banbatakumi/RCJ2024_OPEN/Software/RobotViewer/robot_image.png

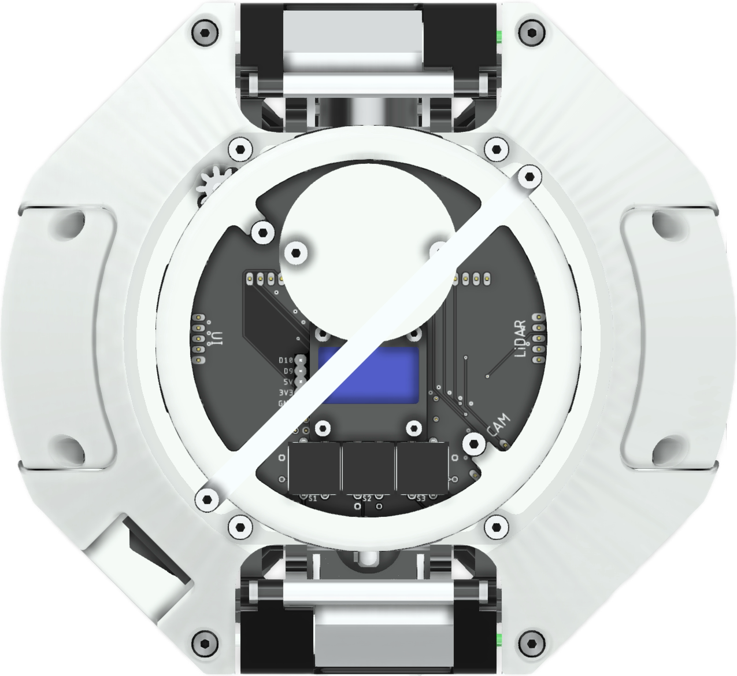
Software/RobotViewer/robot_image.png
