banbatakumi/RCJ2024_OPEN/Hardware/Curcuit/kicker_ver/kicker/kicker.brd

## EAGLE design Hardware/Curcuit/kicker_ver/kicker/kicker.brd (2025-04-20)

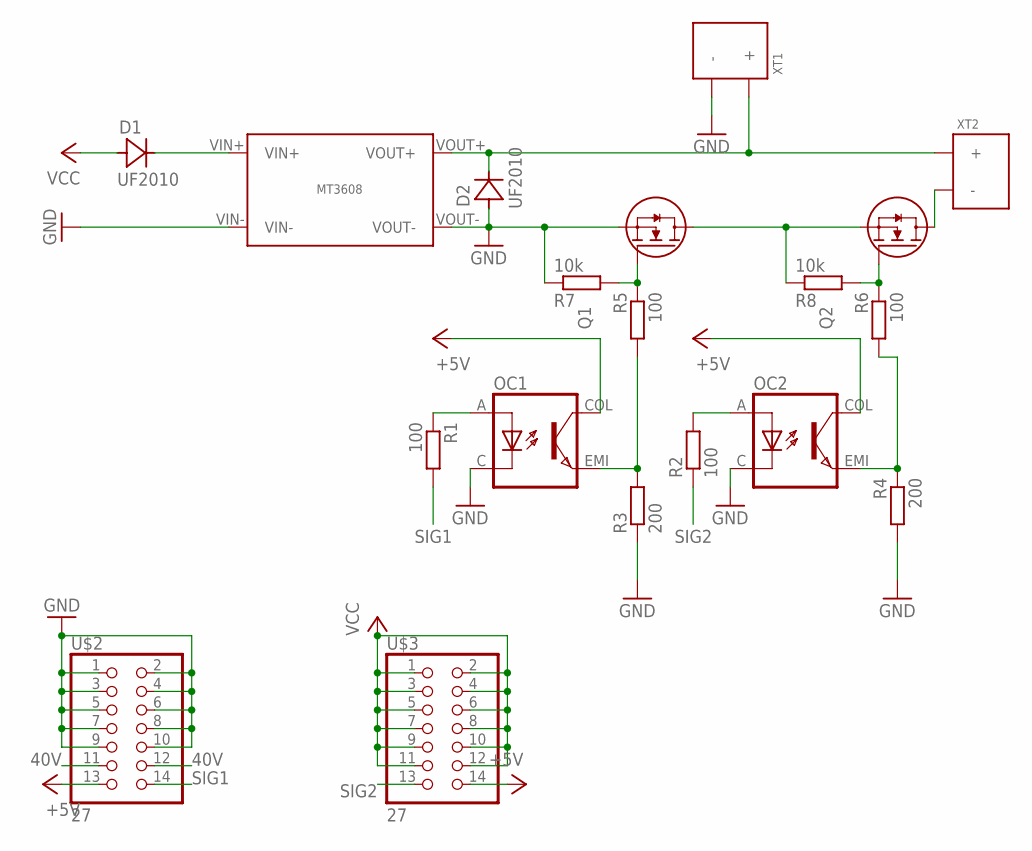
[picture p2: schematic kicker.sch]

Parts:
D1, D2: UF2010
OC1, OC2: TL293(GB); SOIC127P700X230-4N
Q1, Q2: NP52N06SLG; TO230P1040X230-3N
R1, R2, R5, R6: 100; R0603
R3, R4: 200; R0603
R7, R8: 10k; R0603
U$1: MT3608
U$2, U$3: 27; 2*7
XT1, XT2: XT30PW-F

Connections:
40V: D2.C, U$1.VOUT+, U$2.11, U$2.12, XT1.+, XT2.+
+5V: OC1.COL, OC2.COL, U$2.13, U$3.14
GND: D2.A, OC1.C, OC2.C, Q1.S, R3.1, R4.2, R7.1, U$1.VIN-, U$1.VOUT-, U$2.1, U$2.2, U$2.3, U$2.4, U$2.5, U$2.6, U$2.7, U$2.8, U$2.9, U$2.10, XT1.-
unnamed: D1.C, U$1.VIN+
unnamed: Q1.D, Q2.S, R8.1
unnamed: OC1.EMI, R3.2, R5.2
unnamed: Q2.D, XT2.-
unnamed: OC1.A, R1.1
unnamed: OC2.A, R2.2
unnamed: OC2.EMI, R4.1, R6.2
unnamed: Q1.G, R5.1, R7.2
unnamed: Q2.G, R6.1, R8.2
SIG1: R1.2, U$2.14
SIG2: R2.1, U$3.13
VCC: D1.A, U$3.1, U$3.2, U$3.3, U$3.4, U$3.5, U$3.6, U$3.7, U$3.8, U$3.9, U$3.10, U$3.11, U$3.12

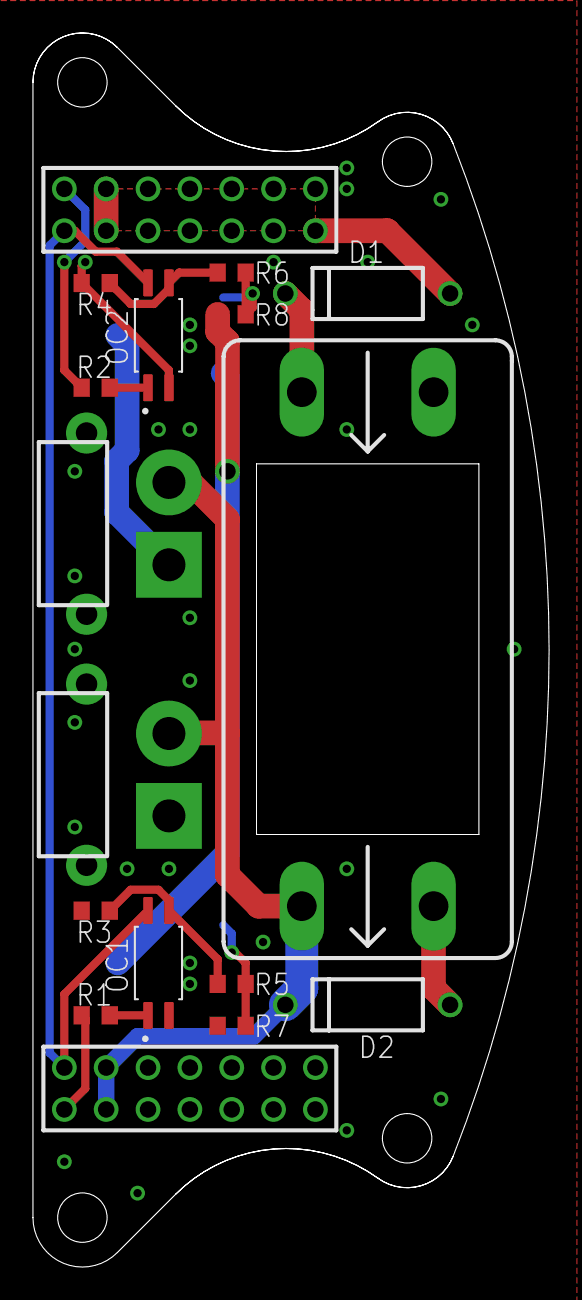
[picture p3: board kicker.brd from above]

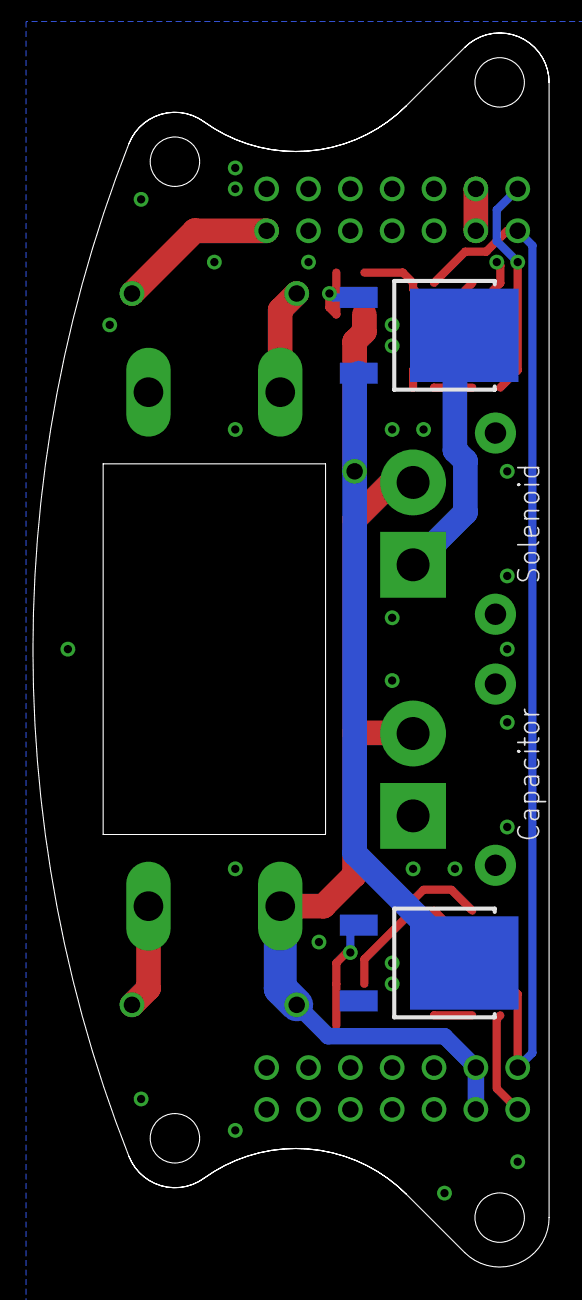
[picture p4: board kicker.brd from below]

Board: 2 copper layers, 31.3 x 74.9 mm, 19 parts (2 on the bottom side), 15 nets.
