banbatakumi/RCJ2024_OPEN/Hardware/Curcuit/Line/Line.brd

## EAGLE design Hardware/Curcuit/Line/Line.brd (2025-04-20)

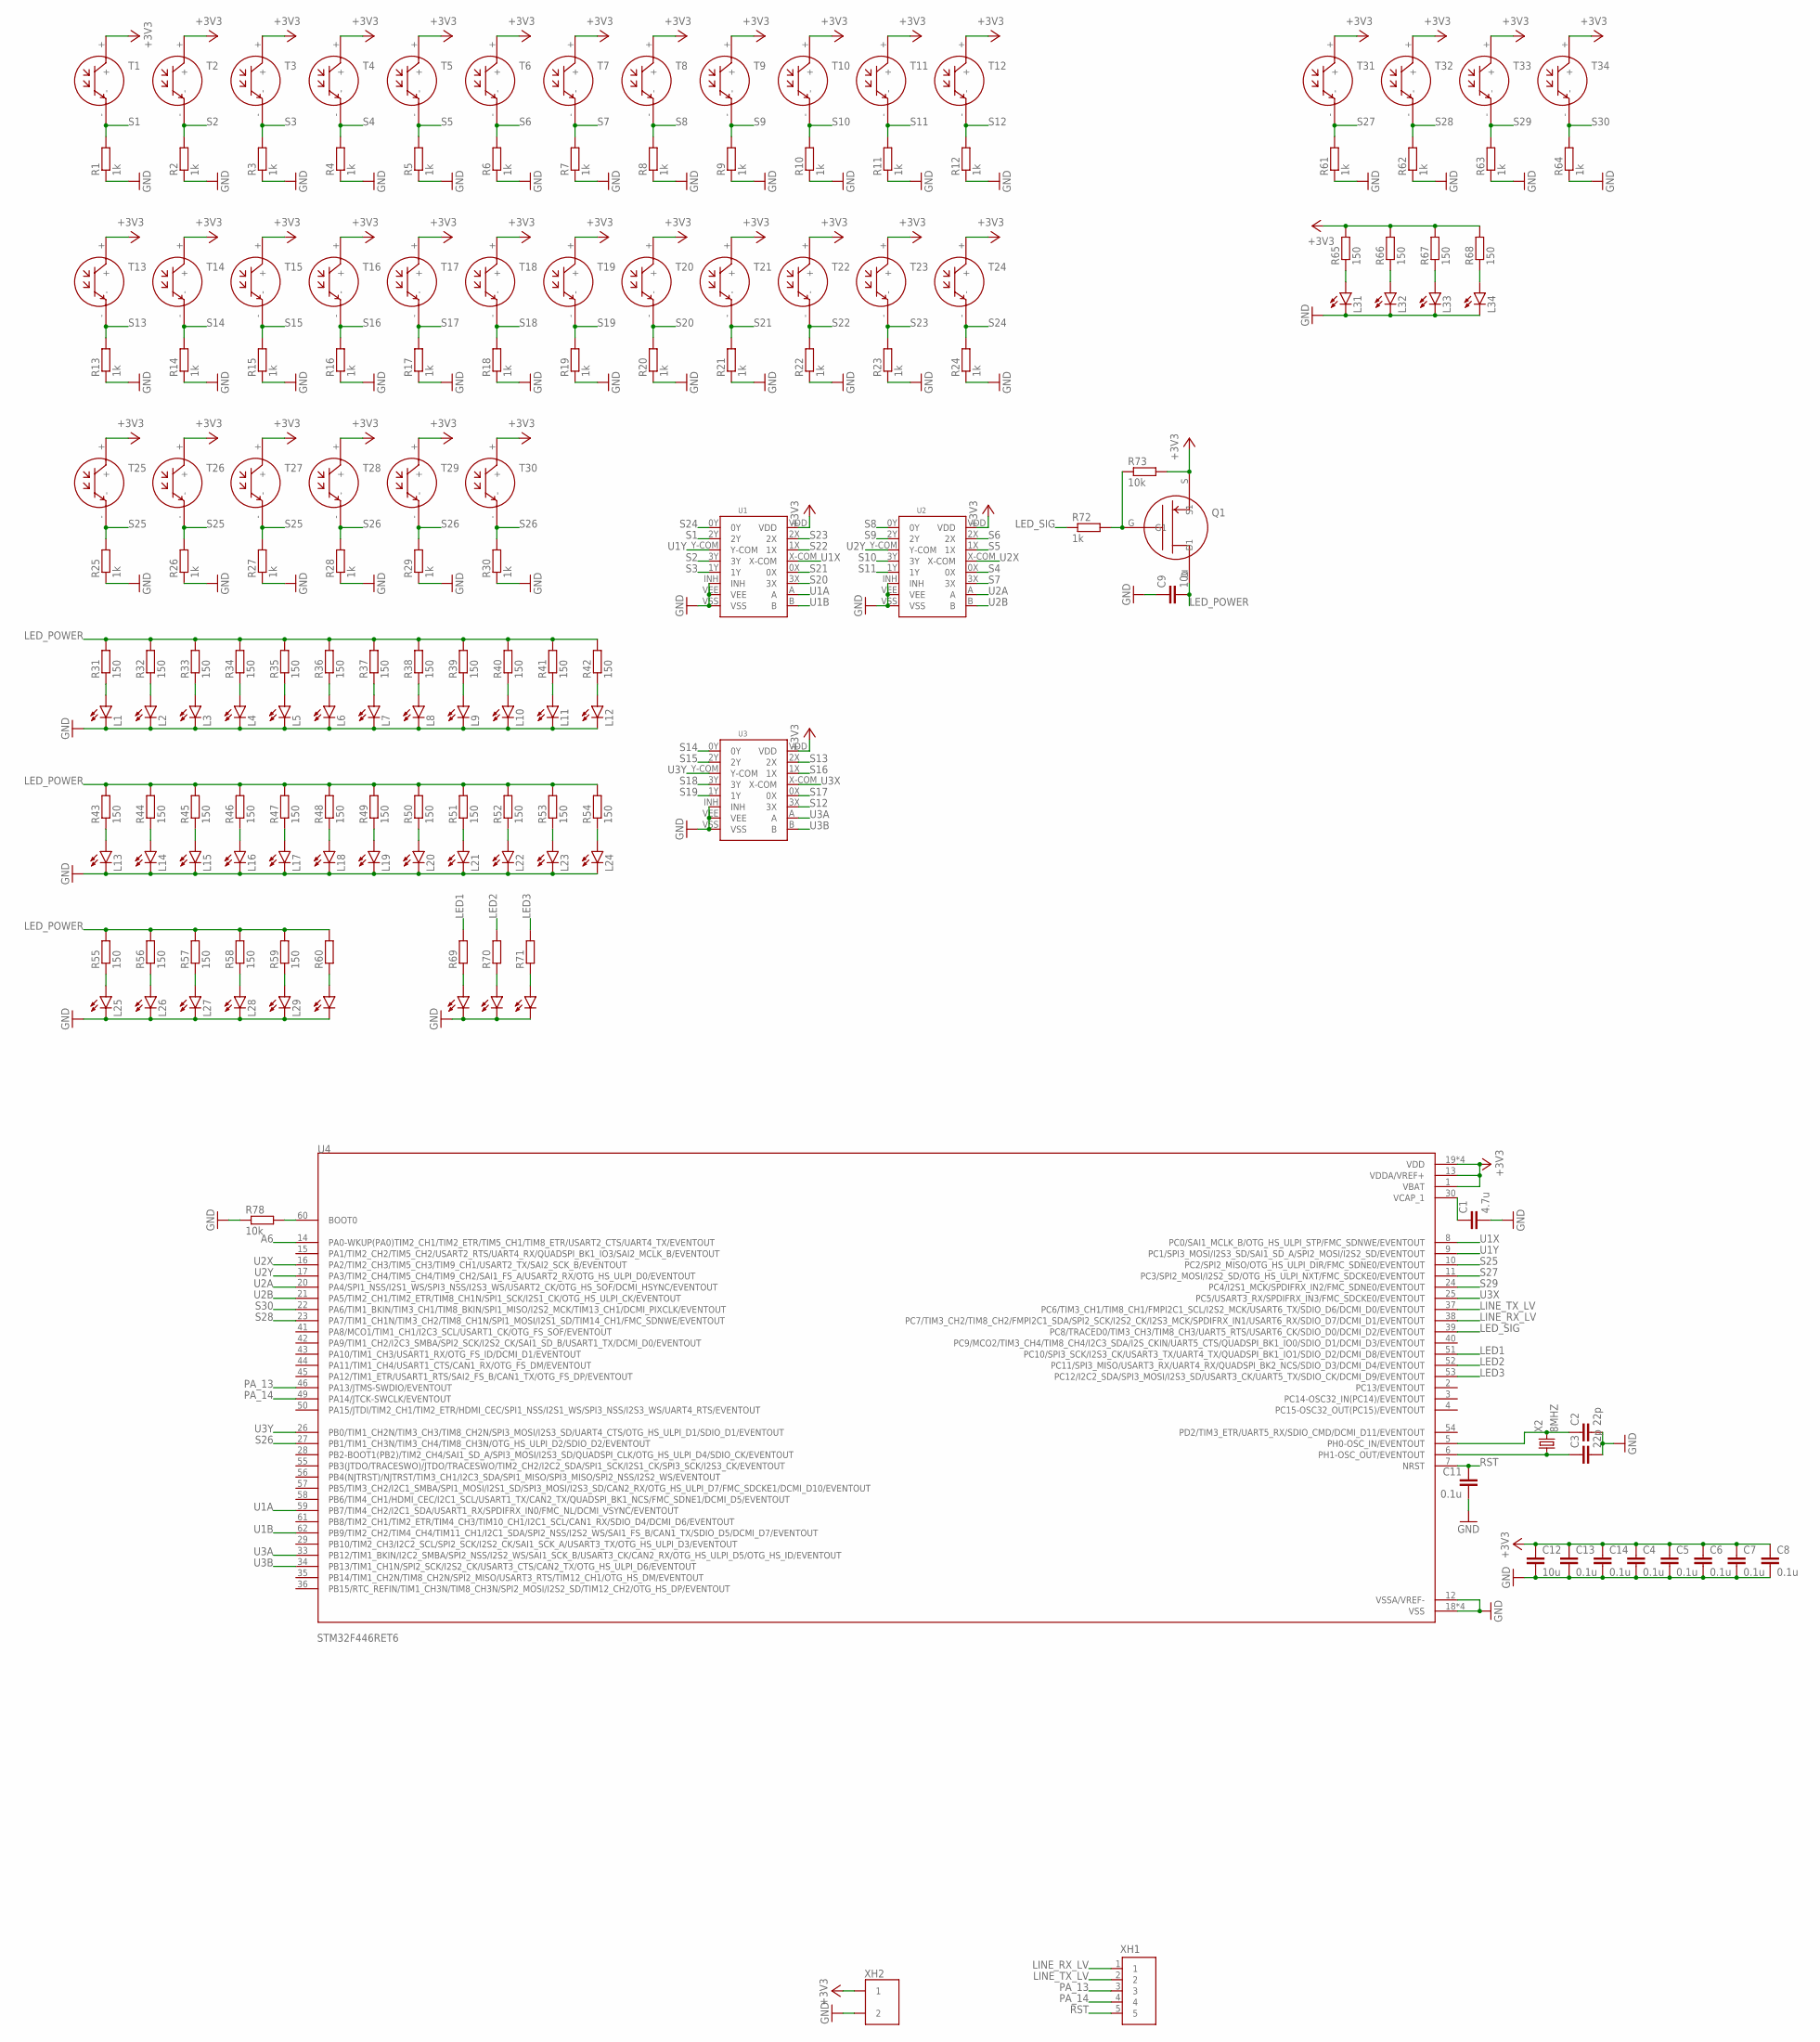
[picture p5: schematic Line.sch]

Parts:
C1: 4.7u; C0603
C2, C3: 22p; C0603
C4, C5, C6, C7, C8, C11, C13, C14: 0.1u; C0603
C9, C12: 10u; C0805
L1, L2, L3, L4, L5, L6, L7, L8, L9, L10, L11, L12, L13, L14, L15, L16, L17, L18, L19, L20, L21, L22, L23, L24, L25, L26, L27, L28, L29, L30, L31, L32, L33, L34, L35, L36, L37: SML-E12P8WT86; LED_SML-LXFM0603SIC-TR
Q1: TJ60S04M3L; DPACK
R1, R2, R3, R4, R5, R6, R7, R8, R9, R10, R11, R12, R13, R14, R15, R16, R17, R18, R19, R20, R21, R22, R23, R24, R25, R26, R27, R28, R29, R30, R61, R62, R63, R64, R72: 1k; R0603
R31, R32, R33, R34, R35, R36, R37, R38, R39, R40, R41, R42, R43, R44, R45, R46, R47, R48, R49, R50, R51, R52, R53, R54, R55, R56, R57, R58, R59, R60, R65, R66, R67, R68, R69, R70, R71: 150; R0603
R73, R78: 10k; R0603
T1, T2, T3, T4, T5, T6, T7, T8, T9, T10, T11, T12, T13, T14, T15, T16, T17, T18, T19, T20, T21, T22, T23, T24, T25, T26, T27, T28, T29, T30, T31, T32, T33, T34: NJL7302L-F3
U1, U2, U3: TC4051BP
U4: STM32F446RET6; QFP50P1200X1200X160-64N
X2: 8MHZ; 16MHZ
XH1: 5B
XH2: 2B

Connections:
+3V3: C4.1, C5.1, C6.1, C7.1, C8.1, C12.1, C13.1, C14.1, Q1.S (S1), R65.2, R66.2, R67.2, R68.2, R73.2, T1.+, T2.+, T3.+, T4.+, T5.+, T6.+, T7.+, T8.+, T9.+, T10.+, T11.+, T12.+, T13.+, T14.+, T15.+, T16.+, T17.+, T18.+, T19.+, T20.+, T21.+, T22.+, T23.+, T24.+, T25.+, T26.+, T27.+, T28.+, T29.+, T30.+, T31.+, T32.+, T33.+, T34.+, U1.VDD, U2.VDD, U3.VDD, U4.1 (VBAT), U4.13 (VDDA/VREF+), U4.19 (VDD), U4.32 (VDD), U4.48 (VDD), U4.64 (VDD), XH2.P$1 (1)
A6: U4.14 (PA0-WKUP(PA0)TIM2_CH1/TIM2_ETR/TIM5_CH1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)
GND: C1.2, C2.2, C3.2, C4.2, C5.2, C6.2, C7.2, C8.2, C9.1, C11.2, C12.2, C13.2, C14.2, L1.C, L2.C, L3.C, L4.C, L5.C, L6.C, L7.C, L8.C, L9.C, L10.C, L11.C, L12.C, L13.C, L14.C, L15.C, L16.C, L17.C, L18.C, L19.C, L20.C, L21.C, L22.C, L23.C, L24.C, L25.C, L26.C, L27.C, L28.C, L29.C, L30.C, L31.C, L32.C, L33.C, L34.C, L35.C, L36.C, L37.C, R1.1, R2.1, R3.1, R4.1, R5.1, R6.1, R7.1, R8.1, R9.1, R10.1, R11.1, R12.1, R13.1, R14.1, R15.1, R16.1, R17.1, R18.1, R19.1, R20.1, R21.1, R22.1, R23.1, R24.1, R25.1, R26.1, R27.1, R28.1, R29.1, R30.1, R61.1, R62.1, R63.1, R64.1, R78.1, U1.INH, U1.VEE, U1.VSS, U2.INH, U2.VEE, U2.VSS, U3.INH, U3.VEE, U3.VSS, U4.12 (VSSA/VREF-), U4.18 (VSS), U4.31 (VSS), U4.47 (VSS), U4.63 (VSS), XH2.P$2 (2)
LED1: R69.2, U4.51 (PC10/SPI3_SCK/I2S3_CK/USART3_TX/UART4_T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)
LED2: R70.2, U4.52 (PC11/SPI3_MISO/USART3_RX/UART4_RX/QUADS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)
LED3: R71.2, U4.53 (PC12/I2C2_SDA/SPI3_MOSI/I2S3_SD/USART3_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)
LED_POWER: C9.2, Q1.D (D1), R31.2, R32.2, R33.2, R34.2, R35.2, R36.2, R37.2, R38.2, R39.2, R40.2, R41.2, R42.2, R43.2, R44.2, R45.2, R46.2, R47.2, R48.2, R49.2, R50.2, R51.2, R52.2, R53.2, R54.2, R55.2, R56.2, R57.2, R58.2, R59.2, R60.2
LED_SIG: R72.1, U4.39 (PC8/TRACED0/TIM3_CH3/TIM8_CH3/UART5_RTS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)
LINE_RX_LV: U4.38 (PC7/TIM3_CH2/TIM8_CH2/FMPI2C1_SDA/SPI2_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), XH1.1
LINE_TX_LV: U4.37 (PC6/TIM3_CH1/TIM8_CH1/FMPI2C1_SCL/I2S2_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), XH1.2
unnamed: L1.A, R31.1
unnamed: L2.A, R32.1
unnamed: L3.A, R33.1
unnamed: L4.A, R34.1
unnamed: L5.A, R35.1
unnamed: L6.A, R36.1
unnamed: L7.A, R37.1
unnamed: L8.A, R38.1
unnamed: L9.A, R39.1
unnamed: L10.A, R40.1
unnamed: L11.A, R41.1
unnamed: L12.A, R42.1
unnamed: L13.A, R43.1
unnamed: L14.A, R44.1
unnamed: L15.A, R45.1
unnamed: L16.A, R46.1
unnamed: L17.A, R47.1
unnamed: L18.A, R48.1
unnamed: L19.A, R49.1
unnamed: L20.A, R50.1
unnamed: L21.A, R51.1
unnamed: L22.A, R52.1
unnamed: L23.A, R53.1
unnamed: L24.A, R54.1
unnamed: L25.A, R55.1
unnamed: L26.A, R56.1
unnamed: L27.A, R57.1
unnamed: L28.A, R58.1
unnamed: L29.A, R59.1
unnamed: L30.A, R60.1
unnamed: L31.A, R65.1
unnamed: L32.A, R66.1
unnamed: L33.A, R67.1
unnamed: L34.A, R68.1
unnamed: L35.A, R69.1
unnamed: L36.A, R70.1
unnamed: L37.A, R71.1
unnamed: Q1.G (G1), R72.2, R73.1
unnamed: C1.1, U4.30 (VCAP_1)
unnamed: R78.2, U4.60 (BOOT0)
unnamed: C2.1, U4.5 (PH0-OSC_IN/EVENTOUT), X2.P$2 (2)
unnamed: C3.1, U4.6 (PH1-OSC_OUT/EVENTOUT), X2.P$1 (1)
PA_13: U4.46 (PA13/JTMS-SWDIO/EVENTOUT), XH1.3
PA_14: U4.49 (PA14/JTCK-SWCLK/EVENTOUT), XH1.4
RST: C11.1, U4.7 (NRST), XH1.5
S1: R1.2, T1.-, U1.2Y
S2: R2.2, T2.-, U1.3Y
S3: R3.2, T3.-, U1.1Y
S4: R4.2, T4.-, U2.0X
S5: R5.2, T5.-, U2.1X
S6: R6.2, T6.-, U2.2X
S7: R7.2, T7.-, U2.3X
S8: R8.2, T8.-, U2.0Y
S9: R9.2, T9.-, U2.2Y
S10: R10.2, T10.-, U2.3Y
S11: R11.2, T11.-, U2.1Y
S12: R12.2, T12.-, U3.3X
S13: R13.2, T13.-, U3.2X
S14: R14.2, T14.-, U3.0Y
S15: R15.2, T15.-, U3.2Y
S16: R16.2, T16.-, U3.1X
S17: R17.2, T17.-, U3.0X
S18: R18.2, T18.-, U3.3Y
S19: R19.2, T19.-, U3.1Y
S20: R20.2, T20.-, U1.3X
S21: R21.2, T21.-, U1.0X
S22: R22.2, T22.-, U1.1X
S23: R23.2, T23.-, U1.2X
S24: R24.2, T24.-, U1.0Y
S25: R25.2, R26.2, R27.2, T25.-, T26.-, T27.-, U4.10 (PC2/SPI2_MISO/OTG_HS_ULPI_DIR/FMC_SDNE0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)
S26: R28.2, R29.2, R30.2, T28.-, T29.-, T30.-, U4.27 (PB1/TIM1_CH3N/TIM3_CH4/TIM8_CH3N/OTG_HS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)
S27: R61.2, T31.-, U4.11 (PC3/SPI2_MOSI/I2S2_SD/OTG_HS_ULPI_NXT/F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)
S28: R62.2, T32.-, U4.23 (PA7/TIM1_CH1N/TIM3_CH2/TIM8_CH1N/SPI1_M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)
S29: R63.2, T33.-, U4.24 (PC4/I2S1_MCK/SPDIFRX_IN2/FMC_SDNE0/EVEN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)
S30: R64.2, T34.-, U4.22 (PA6/TIM1_BKIN/TIM3_CH1/TIM8_BKIN/SPI1_M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)
U1A: U1.A, U4.59 (PB7/TIM4_CH2/I2C1_SDA/USART1_RX/SPDIFRX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)
U1B: U1.B, U4.62 (PB9/TIM2_CH2/TIM4_CH4/TIM11_CH1/I2C1_SD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)
U1X: U1.X-COM, U4.8 (PC0/SAI1_MCLK_B/OTG_HS_ULPI_STP/FMC_SDN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)
U1Y: U1.Y-COM, U4.9 (PC1/SPI3_MOSI/I2S3_SD/SAI1_SD_A/SPI2_MO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)
U2A: U2.A, U4.20 (PA4/SPI1_NSS/I2S1_WS/SPI3_NSS/I2S3_WS/U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)
U2B: U2.B, U4.21 (PA5/TIM2_CH1/TIM2_ETR/TIM8_CH1N/SPI1_SC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)
U2X: U2.X-COM, U4.16 (PA2/TIM2_CH3/TIM5_CH3/TIM9_CH1/USART2_T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)
U2Y: U2.Y-COM, U4.17 (PA3/TIM2_CH4/TIM5_CH4/TIM9_CH2/SAI1_FS_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)
U3A: U3.A, U4.33 (PB12/TIM1_BKIN/I2C2_SMBA/SPI2_NSS/I2S2_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)
U3B: U3.B, U4.34 (PB13/TIM1_CH1N/SPI2_SCK/I2S2_CK/USART3_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)
U3X: U3.X-COM, U4.25 (PC5/USART3_RX/SPDIFRX_IN3/FMC_SDCKE0/EV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)
U3Y: U3.Y-COM, U4.26 (PB0/TIM1_CH2N/TIM3_CH3/TIM8_CH2N/SPI3_M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)

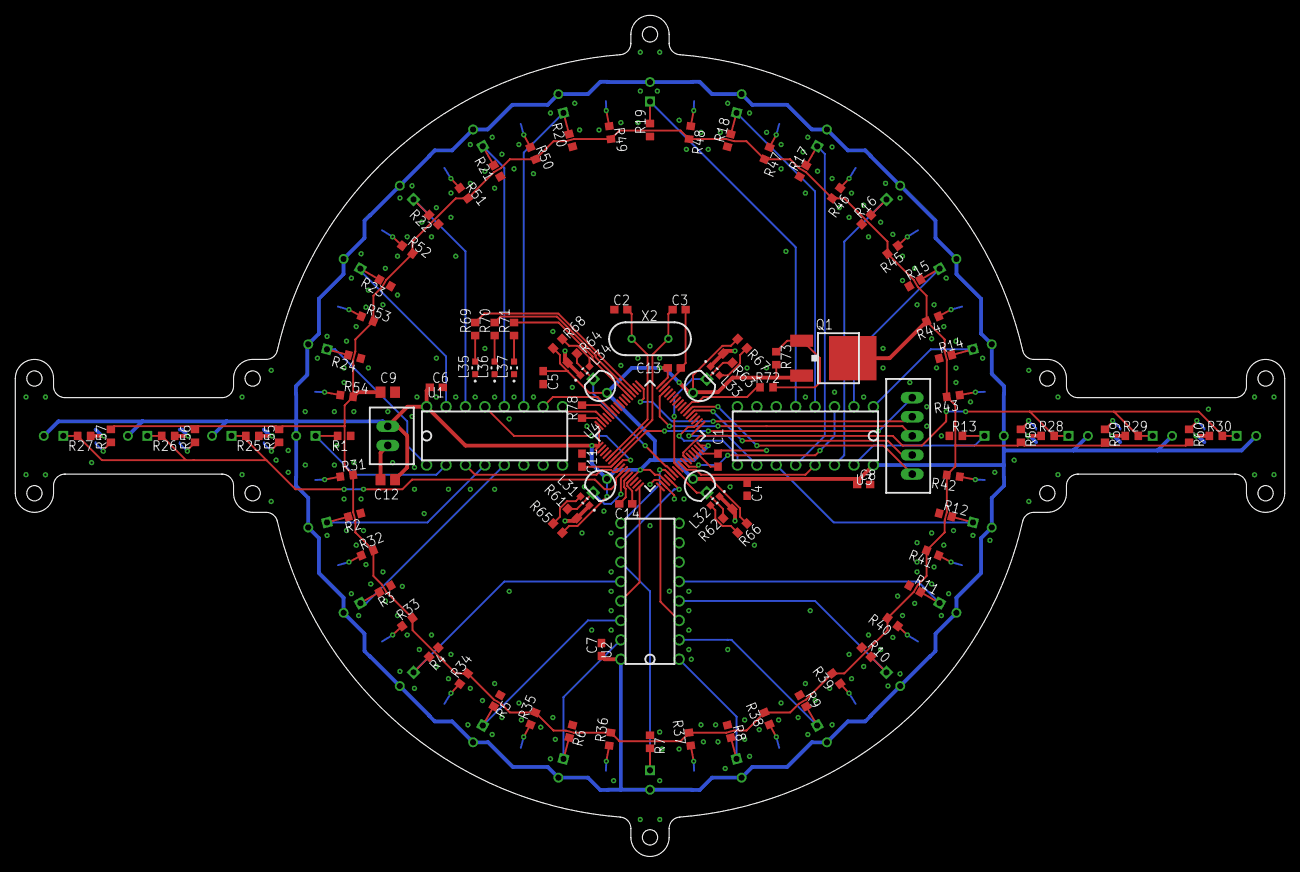
[picture p6: board Line.brd from above]

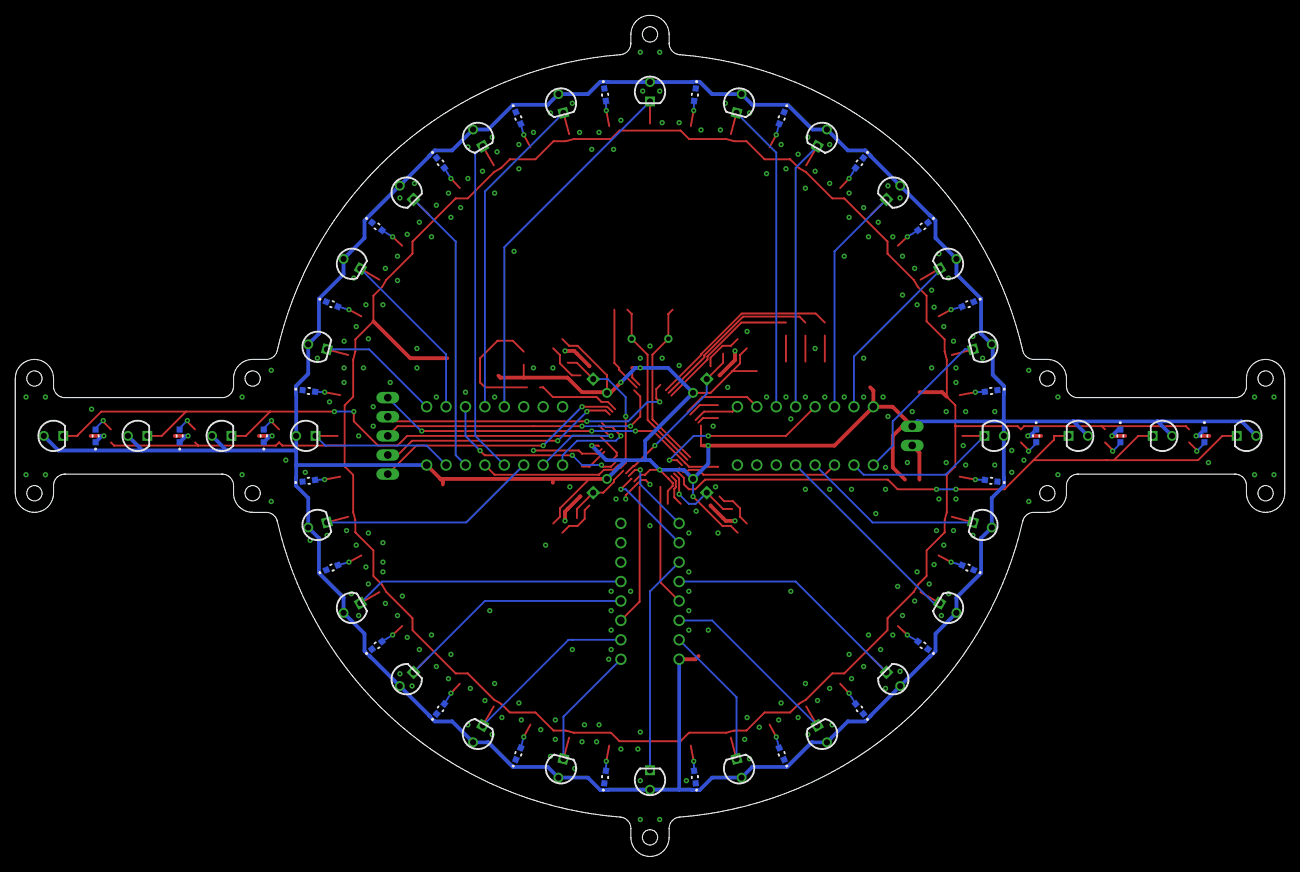
[picture p7: board Line.brd from below]

Board: 2 copper layers, 166.0 x 110.0 mm, 166 parts (60 on the bottom side), 96 nets.
