banbatakumi/RCJ2024_OPEN/Hardware/Curcuit/main_bottom/main_bottom.brd

## EAGLE design Hardware/Curcuit/main_bottom/main_bottom.brd (2025-04-20)

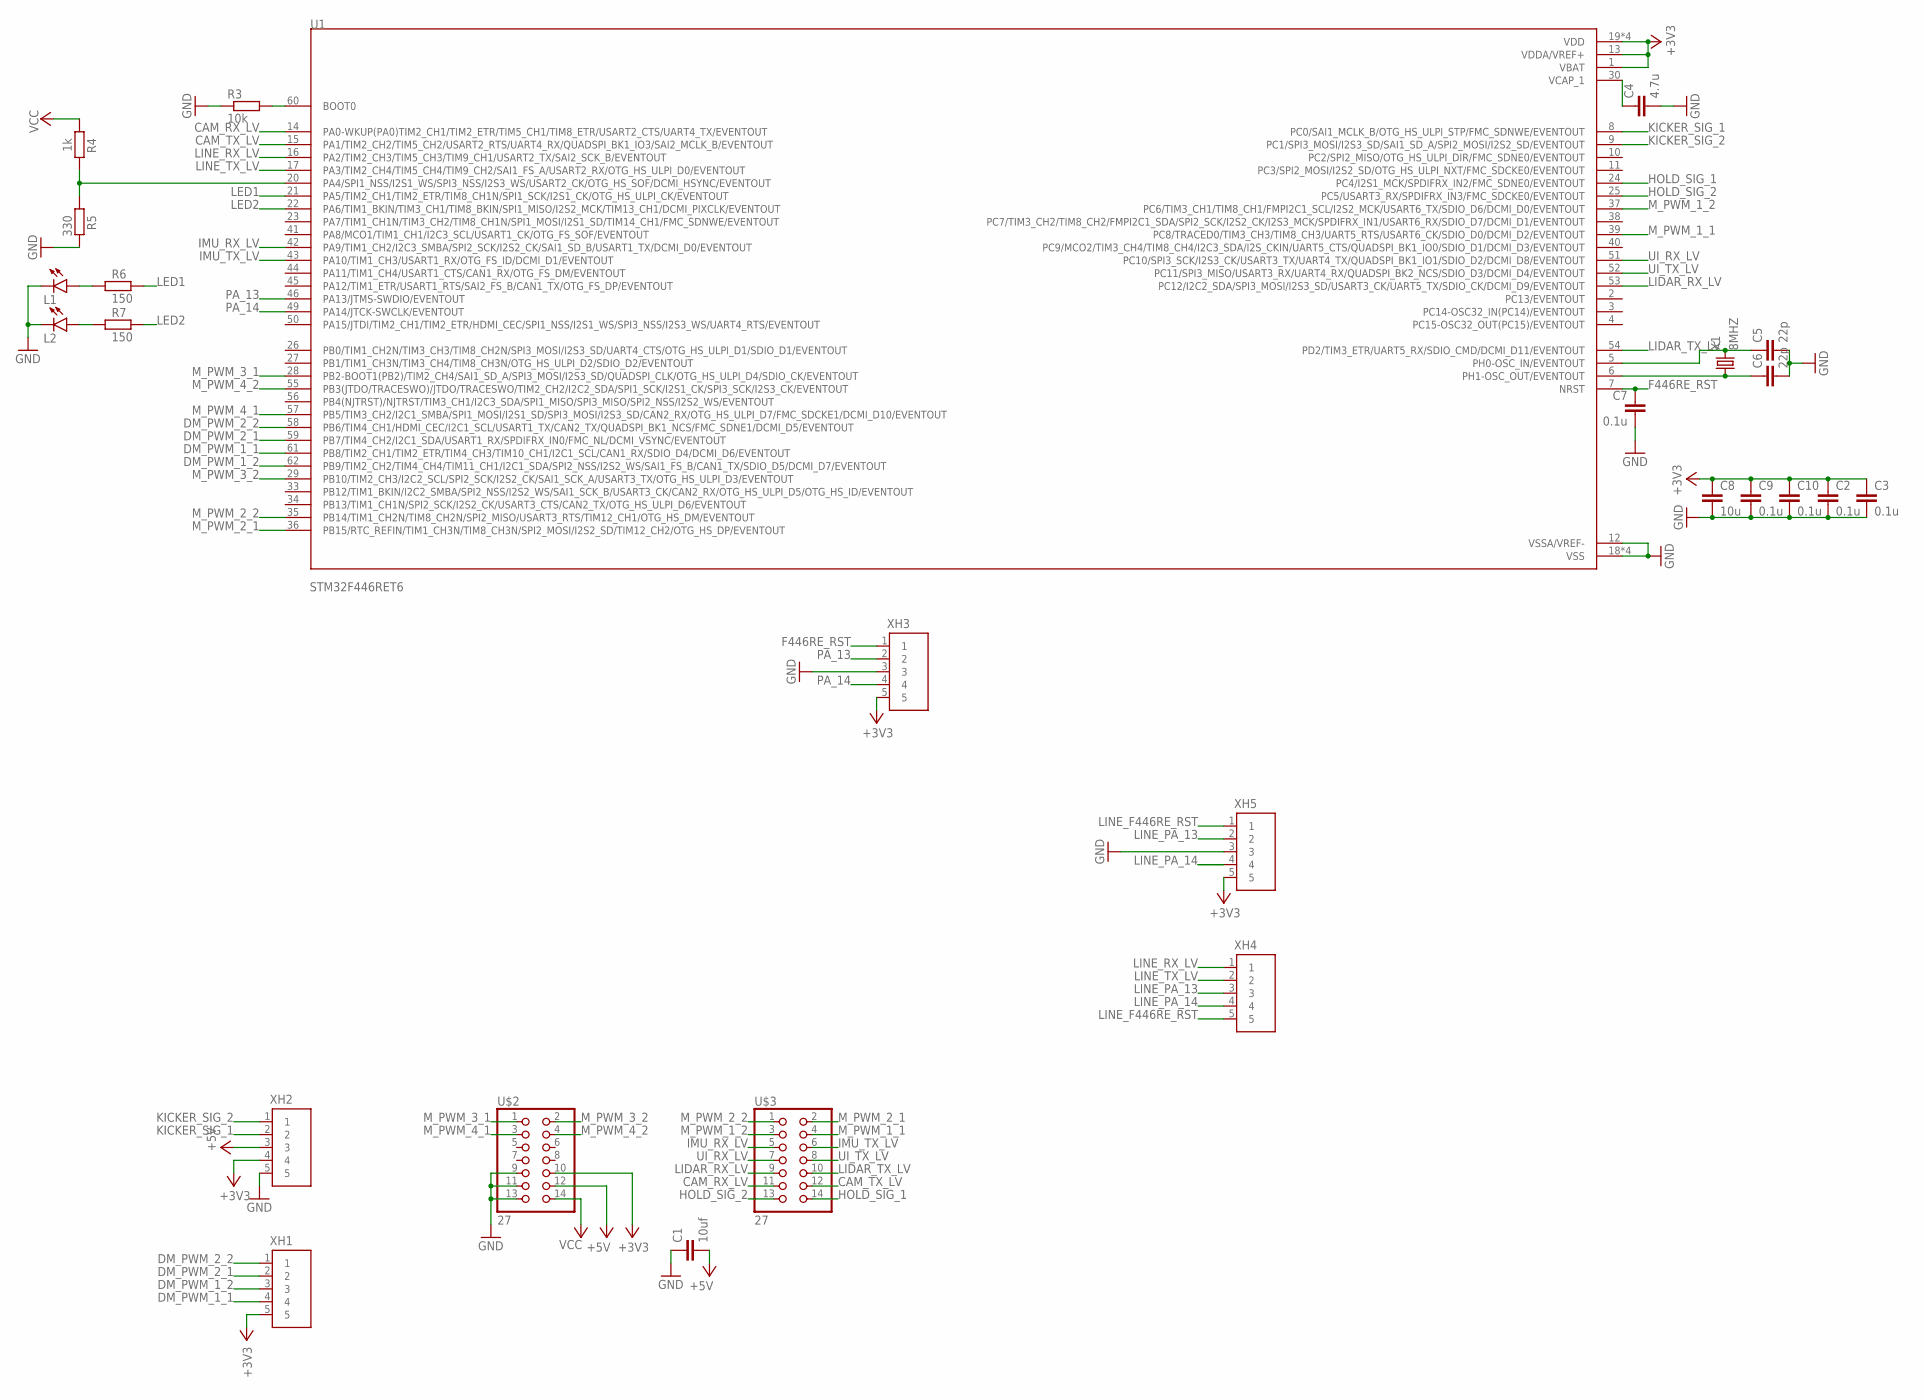
[picture p8: schematic main_bottom.sch]

Parts:
C1: 10uf; C0805
C2, C3, C7, C9, C10: 0.1u; C0603
C4: 4.7u; C0603
C5, C6: 22p; C0603
C8: 10u; C0805
L1, L2: SML-E12P8WT86; LED_SML-LXFM0603SIC-TR
R3: 10k; R0603
R4: 1k; R0603
R5: 330; R0603
R6, R7: 150; R0603
U1: STM32F446RET6; QFP50P1200X1200X160-64N
U$2, U$3: 27; 2*7
X1: 8MHZ; 16MHZ
XH1, XH2, XH3, XH4, XH5: S5B

Connections:
+3V3: C2.1, C3.1, C8.1, C9.1, C10.1, U1.1 (VBAT), U1.13 (VDDA/VREF+), U1.19 (VDD), U1.32 (VDD), U1.48 (VDD), U1.64 (VDD), U$2.10, XH1.5, XH2.4, XH3.5, XH5.5
+5V: C1.2, U$2.12, XH2.3
CAM_RX_LV: U1.14 (PA0-WKUP(PA0)TIM2_CH1/TIM2_ETR/TIM5_CH1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), U$3.11
CAM_TX_LV: U1.15 (PA1/TIM2_CH2/TIM5_CH2/USART2_RTS/UART4_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), U$3.12
DM_PWM_1_1: U1.61 (PB8/TIM2_CH1/TIM2_ETR/TIM4_CH3/TIM10_CH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), XH1.4
DM_PWM_1_2: U1.62 (PB9/TIM2_CH2/TIM4_CH4/TIM11_CH1/I2C1_SD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), XH1.3
DM_PWM_2_1: U1.59 (PB7/TIM4_CH2/I2C1_SDA/USART1_RX/SPDIFRX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), XH1.2
DM_PWM_2_2: U1.58 (PB6/TIM4_CH1/HDMI_CEC/I2C1_SCL/USART1_T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), XH1.1
F446RE_RST: C7.1, U1.7 (NRST), XH3.1
GND: C1.1, C2.2, C3.2, C4.2, C5.2, C6.2, C7.2, C8.2, C9.2, C10.2, L1.C, L2.C, R3.1, R5.2, U1.12 (VSSA/VREF-), U1.18 (VSS), U1.31 (VSS), U1.47 (VSS), U1.63 (VSS), U$2.9, U$2.11, U$2.13, XH2.5, XH3.3, XH5.3
HOLD_SIG_1: U1.24 (PC4/I2S1_MCK/SPDIFRX_IN2/FMC_SDNE0/EVEN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), U$3.14
HOLD_SIG_2: U1.25 (PC5/USART3_RX/SPDIFRX_IN3/FMC_SDCKE0/EV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), U$3.13
IMU_RX_LV: U1.42 (PA9/TIM1_CH2/I2C3_SMBA/SPI2_SCK/I2S2_CK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), U$3.5
IMU_TX_LV: U1.43 (PA10/TIM1_CH3/USART1_RX/OTG_FS_ID/DCMI_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), U$3.6
KICKER_SIG_1: U1.8 (PC0/SAI1_MCLK_B/OTG_HS_ULPI_STP/FMC_SDN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), XH2.2
KICKER_SIG_2: U1.9 (PC1/SPI3_MOSI/I2S3_SD/SAI1_SD_A/SPI2_MO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), XH2.1
LED1: R6.2, U1.21 (PA5/TIM2_CH1/TIM2_ETR/TIM8_CH1N/SPI1_SC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)
LED2: R7.2, U1.22 (PA6/TIM1_BKIN/TIM3_CH1/TIM8_BKIN/SPI1_M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)
LIDAR_RX_LV: U1.53 (PC12/I2C2_SDA/SPI3_MOSI/I2S3_SD/USART3_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), U$3.9
LIDAR_TX_LV: U1.54 (PD2/TIM3_ETR/UART5_RX/SDIO_CMD/DCMI_D11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), U$3.10
LINE_F446RE_RST: XH4.5, XH5.1
LINE_PA_13: XH4.3, XH5.2
LINE_PA_14: XH4.4, XH5.4
LINE_RX_LV: U1.16 (PA2/TIM2_CH3/TIM5_CH3/TIM9_CH1/USART2_T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), XH4.1
LINE_TX_LV: U1.17 (PA3/TIM2_CH4/TIM5_CH4/TIM9_CH2/SAI1_FS_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), XH4.2
M_PWM_1_1: U1.39 (PC8/TRACED0/TIM3_CH3/TIM8_CH3/UART5_RTS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), U$3.4
M_PWM_1_2: U1.37 (PC6/TIM3_CH1/TIM8_CH1/FMPI2C1_SCL/I2S2_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), U$3.3
M_PWM_2_1: U1.36 (PB15/RTC_REFIN/TIM1_CH3N/TIM8_CH3N/SPI2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), U$3.2
M_PWM_2_2: U1.35 (PB14/TIM1_CH2N/TIM8_CH2N/SPI2_MISO/USAR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), U$3.1
M_PWM_3_1: U1.28 (PB2-BOOT1(PB2)/TIM2_CH4/SAI1_SD_A/SPI3_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), U$2.1
M_PWM_3_2: U1.29 (PB10/TIM2_CH3/I2C2_SCL/SPI2_SCK/I2S2_CK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), U$2.2
M_PWM_4_1: U1.57 (PB5/TIM3_CH2/I2C1_SMBA/SPI1_MOSI/I2S1_S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), U$2.3
M_PWM_4_2: U1.55 (PB3(JTDO/TRACESWO)/JTDO/TRACESWO/TIM2_C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), U$2.4
unnamed: C4.1, U1.30 (VCAP_1)
unnamed: R3.2, U1.60 (BOOT0)
unnamed: C5.1, U1.5 (PH0-OSC_IN/EVENTOUT), X1.P$2 (2)
unnamed: C6.1, U1.6 (PH1-OSC_OUT/EVENTOUT), X1.P$1 (1)
unnamed: L2.A, R7.1
unnamed: L1.A, R6.1
PA_13: U1.46 (PA13/JTMS-SWDIO/EVENTOUT), XH3.2
PA_14: U1.49 (PA14/JTCK-SWCLK/EVENTOUT), XH3.4
UI_RX_LV: U1.51 (PC10/SPI3_SCK/I2S3_CK/USART3_TX/UART4_T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), U$3.7
UI_TX_LV: U1.52 (PC11/SPI3_MISO/USART3_RX/UART4_RX/QUADS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), U$3.8
VCC: R4.1, U$2.14
VCC_SIG: R4.2, R5.1, U1.20 (PA4/SPI1_NSS/I2S1_WS/SPI3_NSS/I2S3_WS/U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)

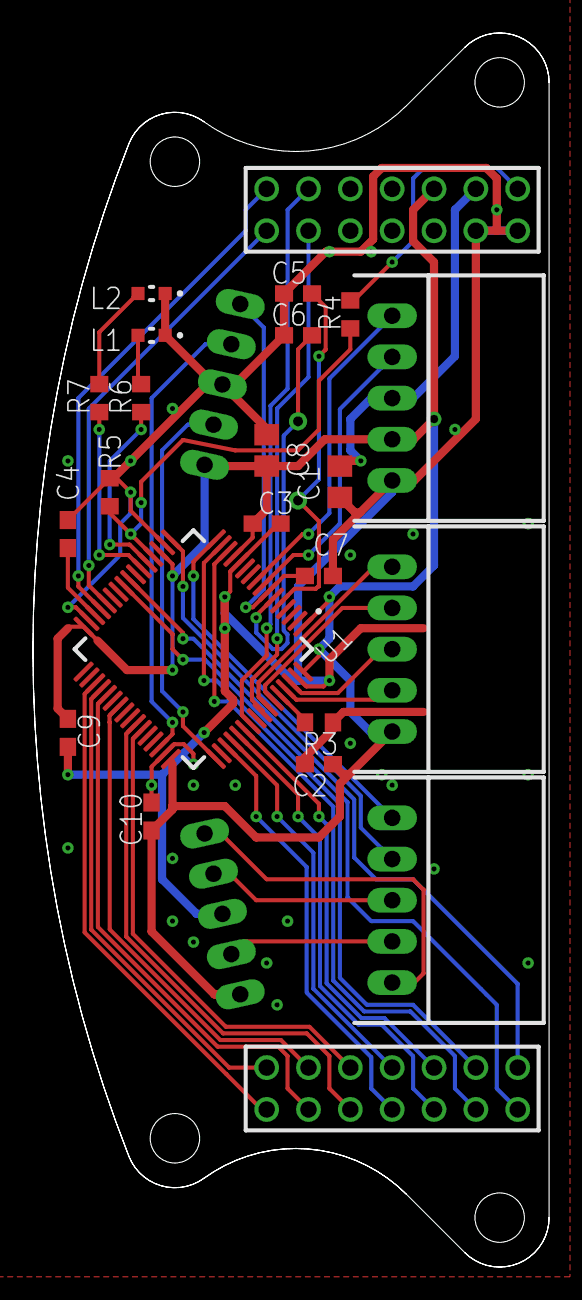
[picture p9: board main_bottom.brd from above]

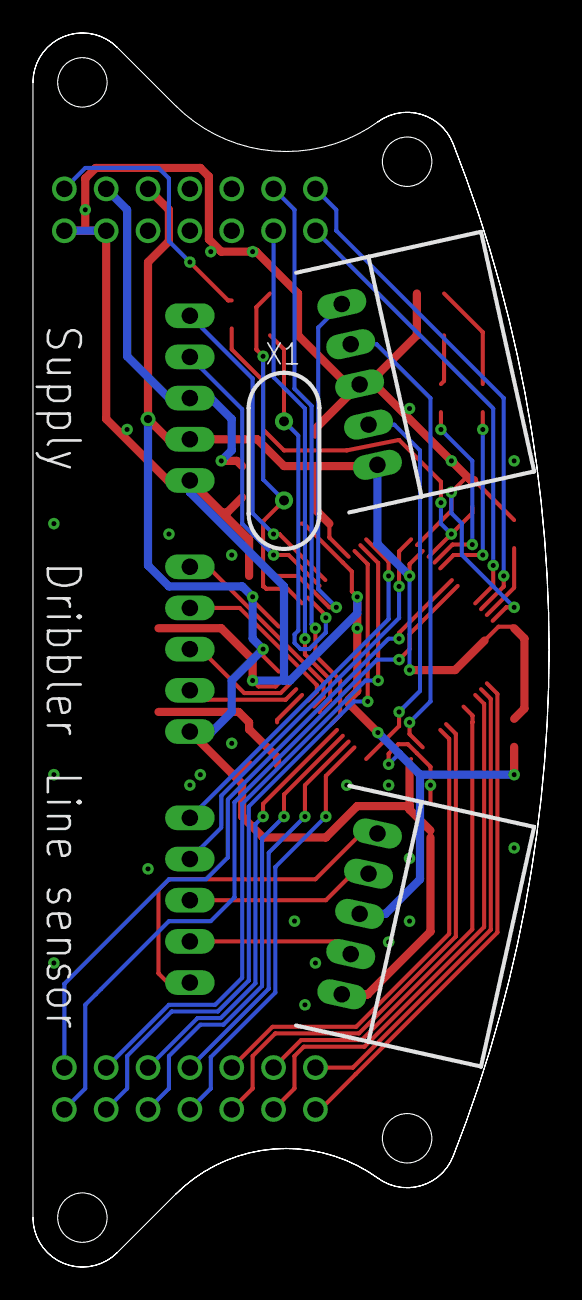
[picture p10: board main_bottom.brd from below]

Board: 2 copper layers, 31.3 x 74.9 mm, 26 parts (3 on the bottom side), 45 nets.
