banbatakumi/RCJ2024_OPEN/Hardware/Curcuit/main_top/main_top.brd

## EAGLE design Hardware/Curcuit/main_top/main_top.brd (continued)

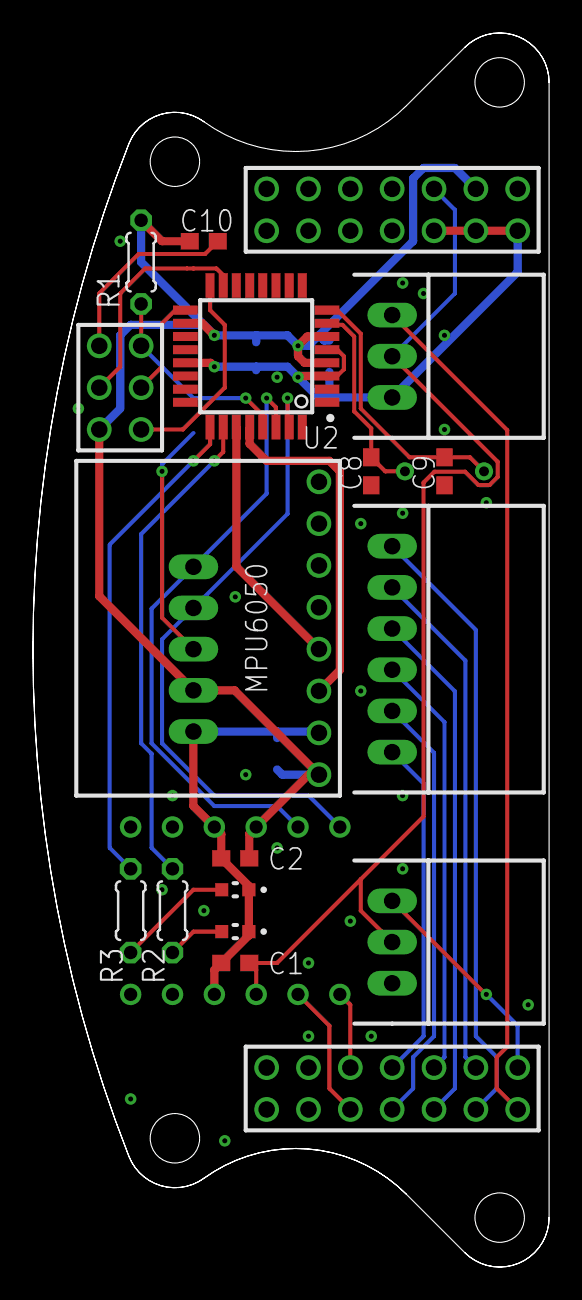
[picture p12: board main_top.brd from above]

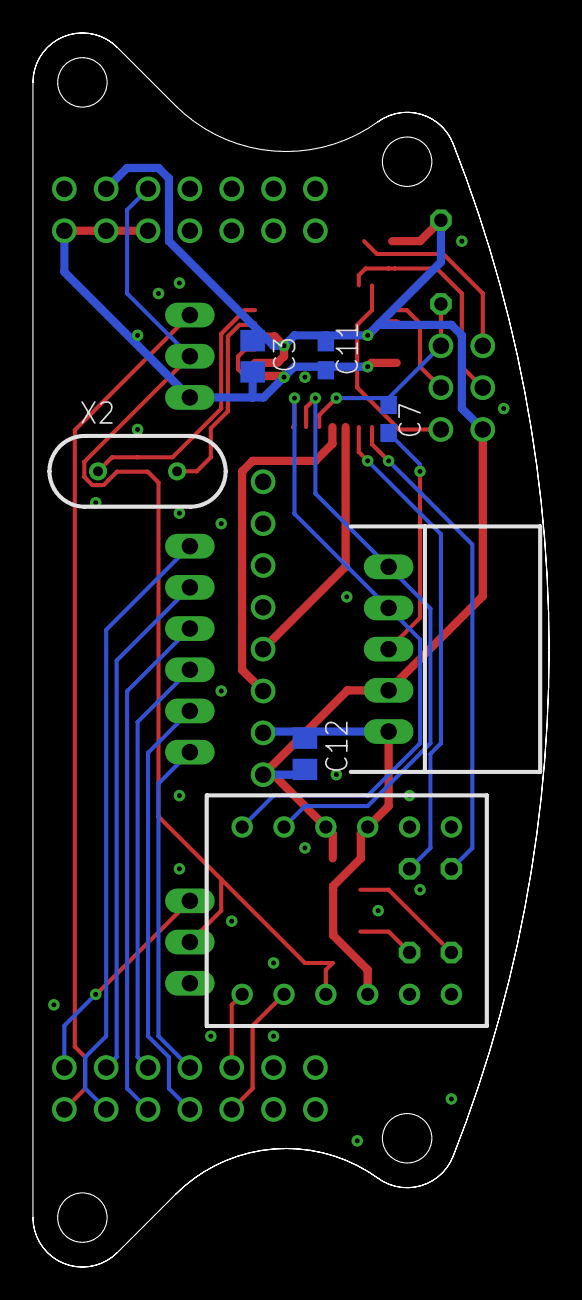
[picture p13: board main_top.brd from below]

Board: 2 copper layers, 31.3 x 74.9 mm, 25 parts (7 on the bottom side), 28 nets.
