banbatakumi/RCJ2024_OPEN/Hardware/Curcuit/IR/ir.brd

## EAGLE design Hardware/Curcuit/IR/ir.brd (2025-04-20)

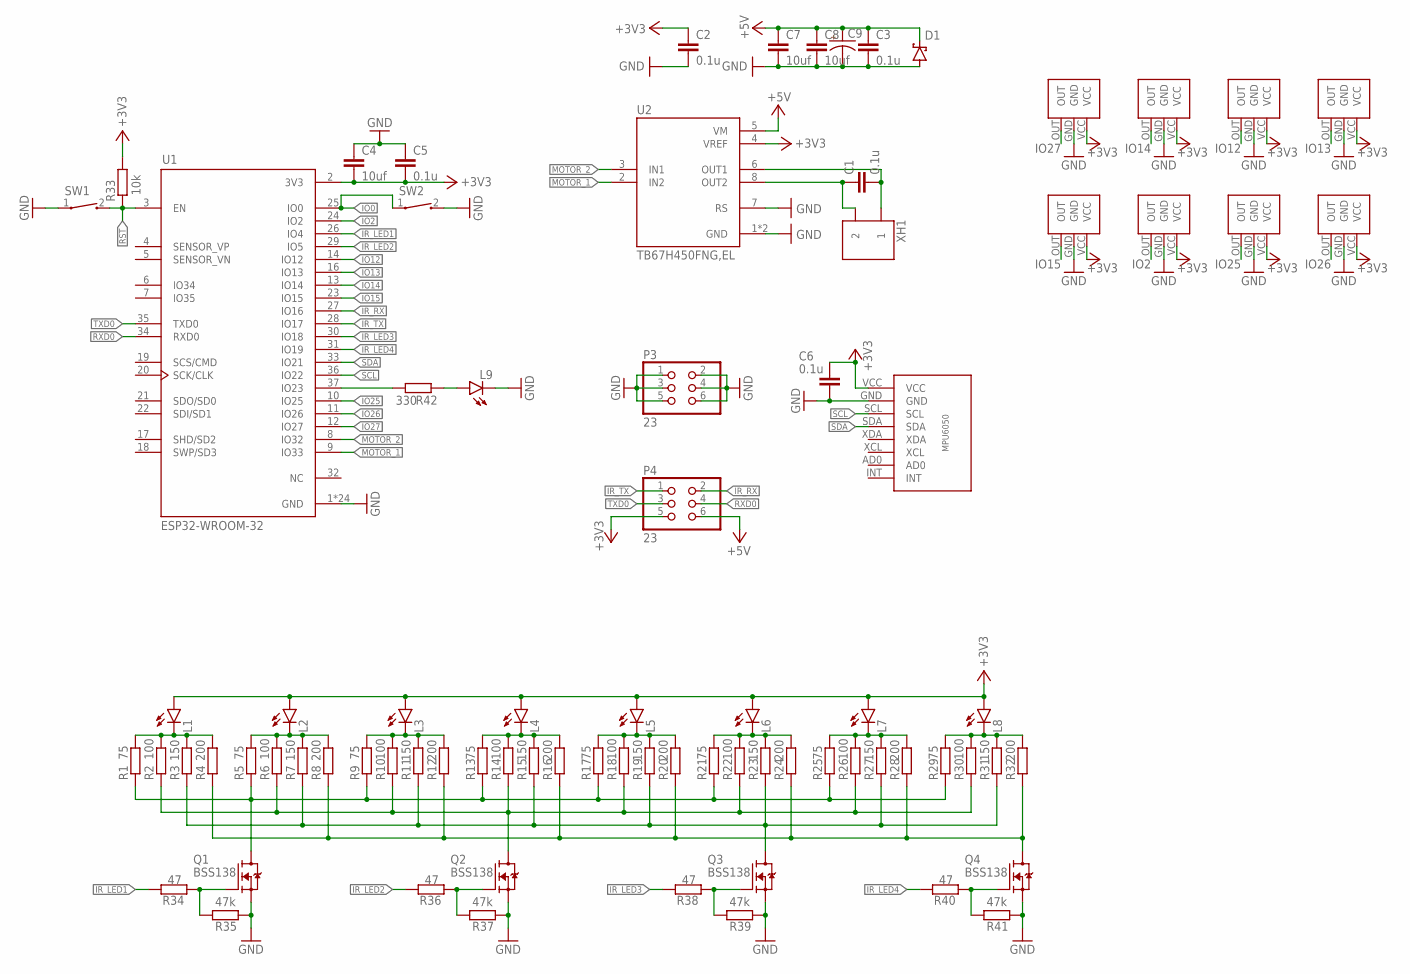
[picture p14: schematic ir.sch]

Parts:
C1, C2, C3, C5, C6: 0.1u; C0603
C4, C7, C8: 10uf; C0805
C9: MH5
D1: SS2040FL; SOD123FL
IR1, IR2, IR3, IR4, IR5, IR6, IR7, IR8: TSSP4038
L1, L2, L3, L4, L5, L6, L7, L8: LED
L9: SML-E12P8WT86; LED_SML-LXFM0603SIC-TR
P3, P4: 23; 2*3
Q1, Q2, Q3, Q4: BSS138; SOT95P240X111-3N
R1, R5, R9, R13, R17, R21, R25, R29: 75; R0603
R2, R6, R10, R14, R18, R22, R26, R30: 100; R0603
R3, R7, R11, R15, R19, R23, R27, R31: 150; R0603
R4, R8, R12, R16, R20, R24, R28, R32: 200; R0603
R33: 10k; R0603
R34, R36, R38, R40: 47; R0603
R35, R37, R39, R41: 47k; R0603
R42: 330; R0603
SW1, SW2: TATE
U1: ESP32-WROOM-32; MODULE_ESP32-WROOM-32
U2: TB67H450FNG,EL; SOIC127P599X175-9N
U$1: MPU6050
XH1: S2B

Connections:
+3V3: C2.1, C4.2, C5.2, C6.1, IR1.VCC, IR2.VCC, IR3.VCC, IR4.VCC, IR5.VCC, IR6.VCC, IR7.VCC, IR8.VCC, L1.+, L2.+, L3.+, L4.+, L5.+, L6.+, L7.+, L8.+, P4.5, R33.2, U1.2 (3V3), U2.4 (VREF), U$1.VCC
+5V: C3.1, C7.1, C8.1, C9.+, D1.C, P4.6, U2.5 (VM)
GND: C2.2, C3.2, C4.1, C5.1, C6.2, C7.2, C8.2, C9.-, D1.A, IR1.GND, IR2.GND, IR3.GND, IR4.GND, IR5.GND, IR6.GND, IR7.GND, IR8.GND, L9.C, P3.1, P3.2, P3.3, P3.4, P3.5, P3.6, Q1.2 (S), Q2.2 (S), Q3.2 (S), Q4.2 (S), R35.2, R37.2, R39.2, R41.2, SW1.1, SW2.2, U1.1 (GND), U1.15 (GND), U1.38 (GND), U1.39_1 (GND), U1.39_2 (GND), U1.39_3 (GND), U1.39_4 (GND), U1.39_5 (GND), U1.39_6 (GND), U1.39_7 (GND), U1.39_8 (GND), U1.39_9 (GND), U1.39_10 (GND), U1.39_11 (GND), U1.39_12 (GND), U1.39_13 (GND), U1.39_14 (GND), U1.39_15 (GND), U1.39_16 (GND), U1.39_17 (GND), U1.39_18 (GND), U1.39_19 (GND), U1.39_20 (GND), U1.39_21 (GND), U2.1 (GND), U2.7 (RS), U2.9 (GND), U$1.GND
IO0: SW2.1, U1.25 (IO0)
IO2: IR6.OUT, U1.24 (IO2)
IO12: IR3.OUT, U1.14 (IO12)
IO13: IR4.OUT, U1.16 (IO13)
IO14: IR2.OUT, U1.13 (IO14)
IO15: IR5.OUT, U1.23 (IO15)
IO25: IR7.OUT, U1.10 (IO25)
IO26: IR8.OUT, U1.11 (IO26)
IO27: IR1.OUT, U1.12 (IO27)
IR_LED1: R34.2, U1.26 (IO4)
IR_LED2: R36.2, U1.29 (IO5)
IR_LED3: R38.2, U1.30 (IO18)
IR_LED4: R40.2, U1.31 (IO19)
IR_RX: P4.2, U1.27 (IO16)
IR_TX: P4.1, U1.28 (IO17)
MOTOR_1: U1.9 (IO33), U2.2 (IN2)
MOTOR_2: U1.8 (IO32), U2.3 (IN1)
unnamed: C1.2, U2.6 (OUT1), XH1.1
unnamed: C1.1, U2.8 (OUT2), XH1.2
unnamed: L1.-, R1.2, R2.2, R3.2, R4.2
unnamed: L2.-, R5.2, R6.2, R7.2, R8.2
unnamed: L3.-, R9.2, R10.2, R11.2, R12.2
unnamed: L4.-, R13.2, R14.2, R15.2, R16.2
unnamed: L5.-, R17.2, R18.2, R19.2, R20.2
unnamed: L6.-, R21.2, R22.2, R23.2, R24.2
unnamed: L7.-, R25.2, R26.2, R27.2, R28.2
unnamed: L8.-, R29.2, R30.2, R31.2, R32.2
unnamed: Q1.3 (D), R1.1, R5.1, R9.1, R13.1, R17.1, R21.1, R25.1, R29.1
unnamed: Q2.3 (D), R2.1, R6.1, R10.1, R14.1, R18.1, R22.1, R26.1, R30.1
unnamed: Q3.3 (D), R3.1, R7.1, R11.1, R15.1, R19.1, R23.1, R27.1, R31.1
unnamed: Q4.3 (D), R4.1, R8.1, R12.1, R16.1, R20.1, R24.1, R28.1, R32.1
unnamed: Q1.1 (G), R34.1, R35.1
unnamed: Q2.1 (G), R36.1, R37.1
unnamed: Q3.1 (G), R38.1, R39.1
unnamed: Q4.1 (G), R40.1, R41.1
unnamed: L9.A, R42.1
unnamed: R42.2, U1.37 (IO23)
RST: R33.1, SW1.2, U1.3 (EN)
RXD0: P4.4, U1.34 (RXD0)
SCL: U1.36 (IO22), U$1.SCL
SDA: U1.33 (IO21), U$1.SDA
TXD0: P4.3, U1.35 (TXD0)

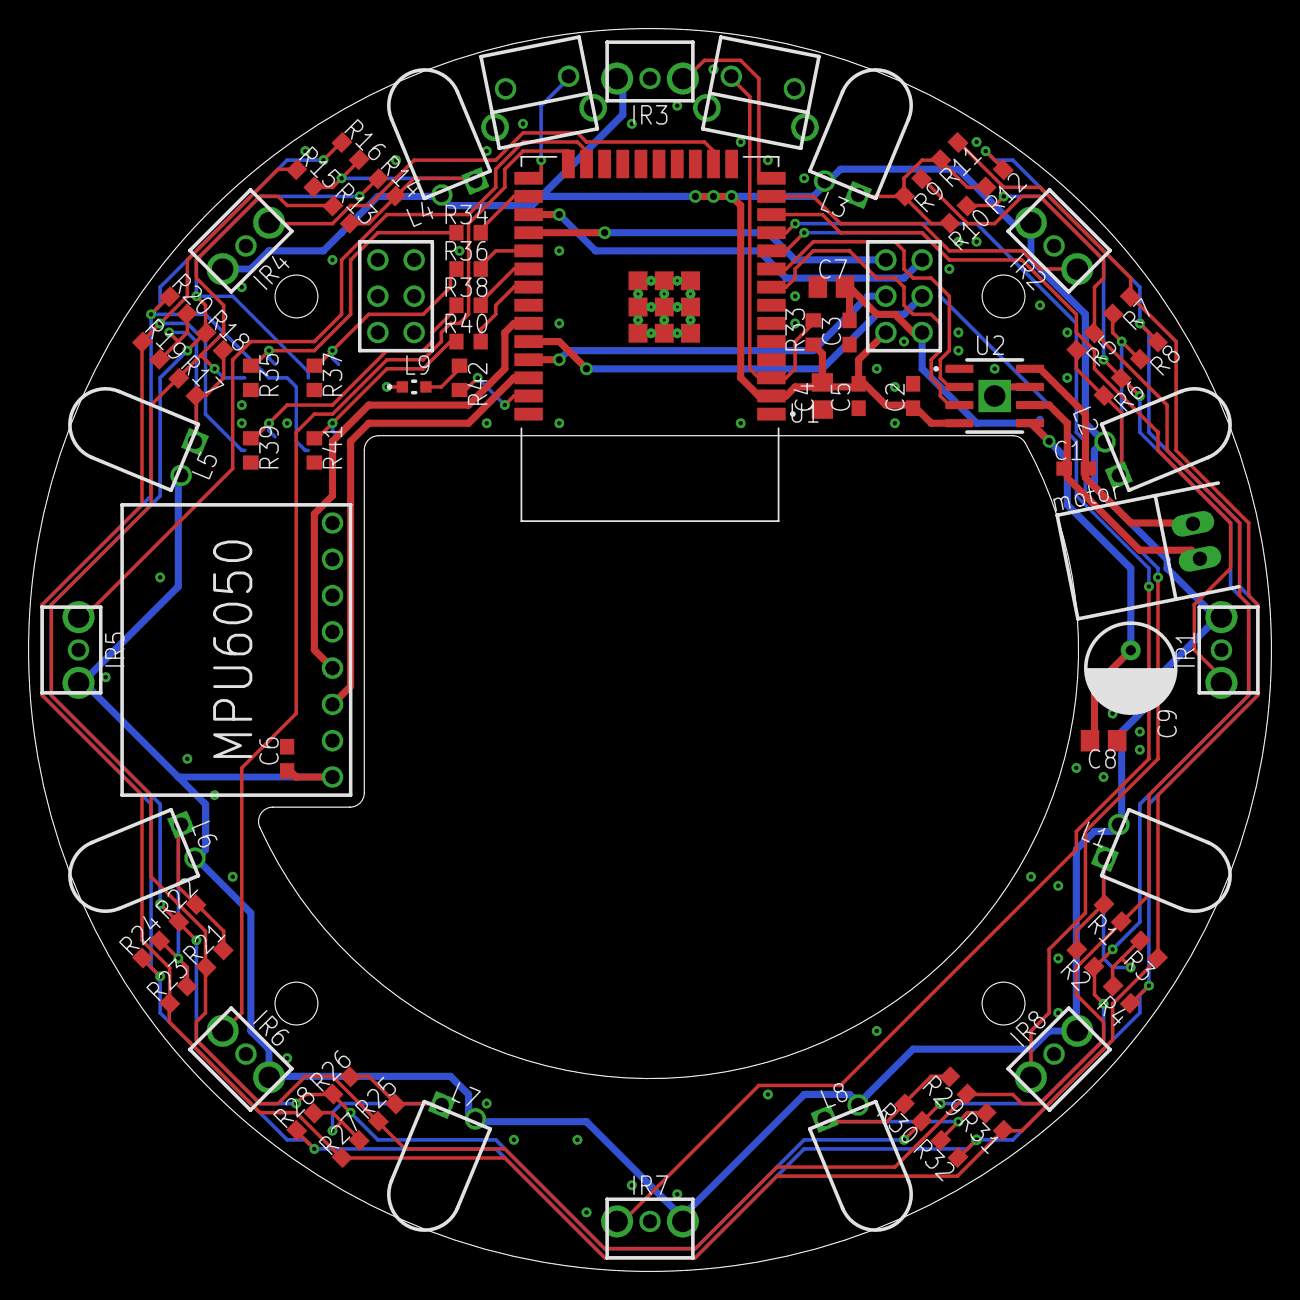
[picture p15: board ir.brd from above]

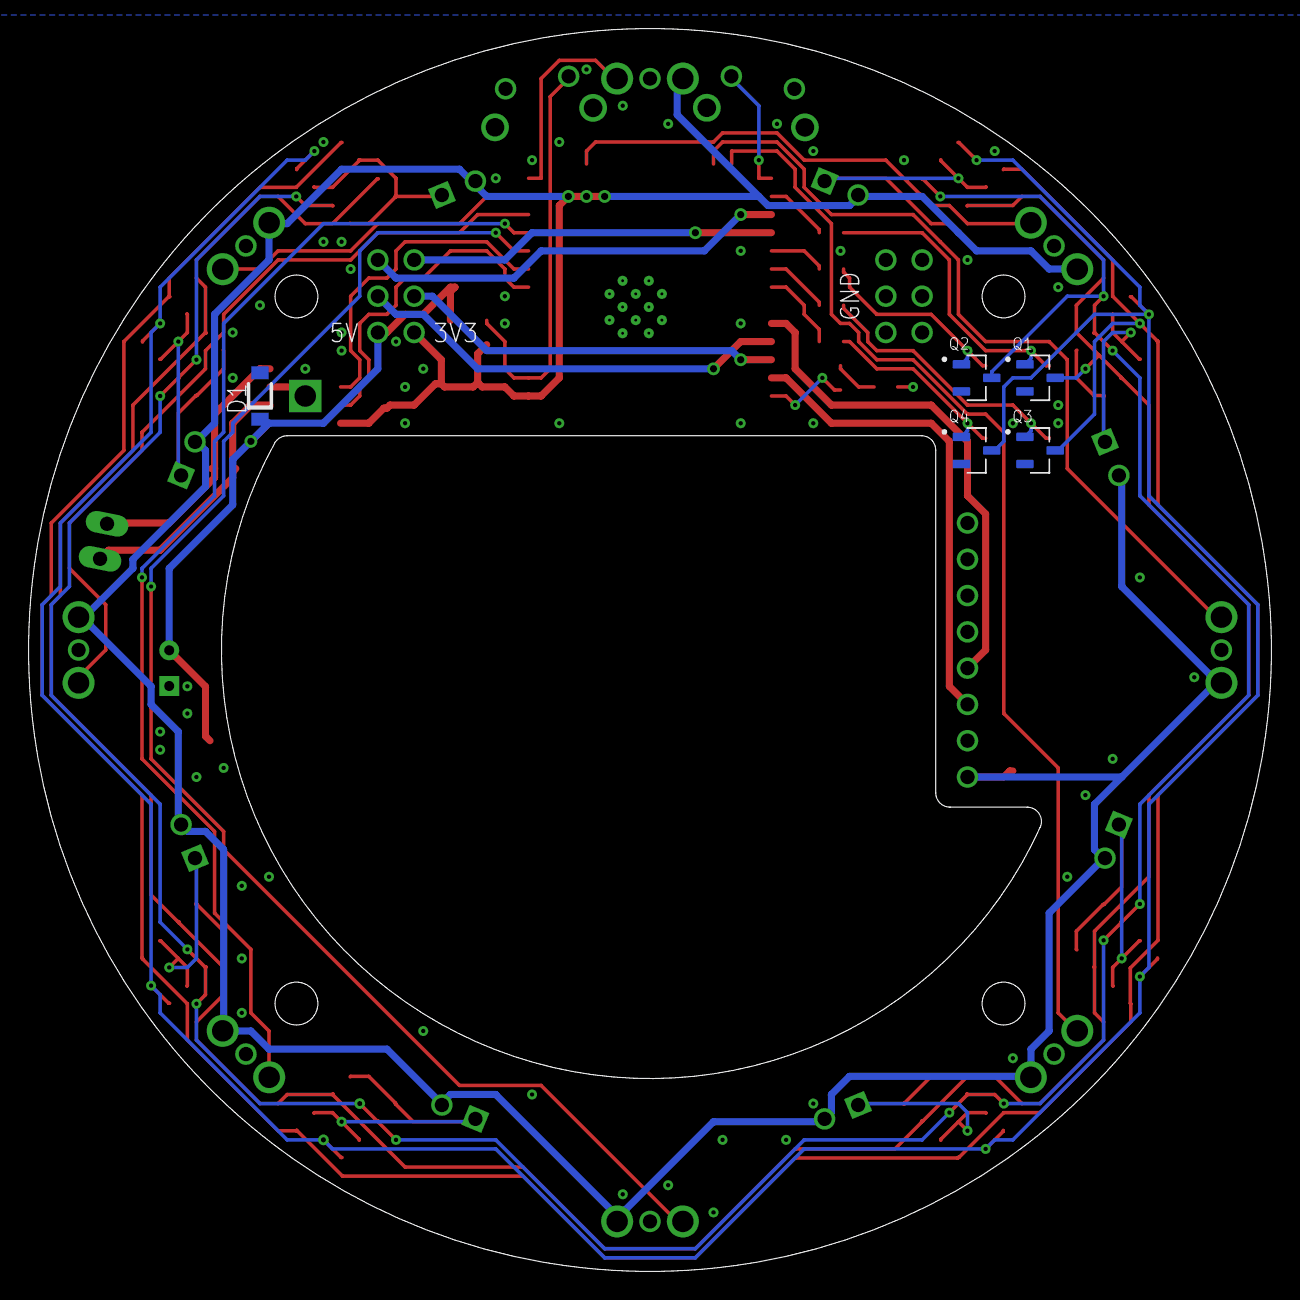
[picture p16: board ir.brd from below]

Board: 2 copper layers, 87.0 x 87.0 mm, 81 parts (5 on the bottom side), 45 nets.
