banbatakumi/RCJ2024_OPEN/Hardware/Curcuit/new_ball_catch/ball_catch_unit_front/ball_catch_unit_front.brd

## EAGLE design Hardware/Curcuit/new_ball_catch/ball_catch_unit_front/ball_catch_unit_front.brd (2025-04-20)

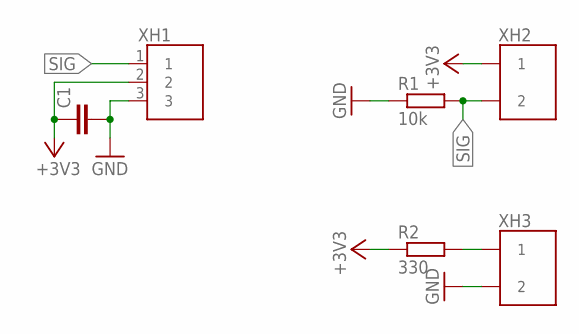
[picture p17: schematic ball_catch_unit_front.sch]

Parts:
C1: C-EUC0603; C0603
R1: 10k; 0204/7
R2: 330; 0204/7
XH1: S3B
XH2: 2B
XH3: S2B

Connections:
+3V3: C1.1, R2.1, XH1.2, XH2.1
GND: C1.2, R1.1, XH1.3, XH3.2
unnamed: R2.2, XH3.1
SIG: R1.2, XH1.1, XH2.2

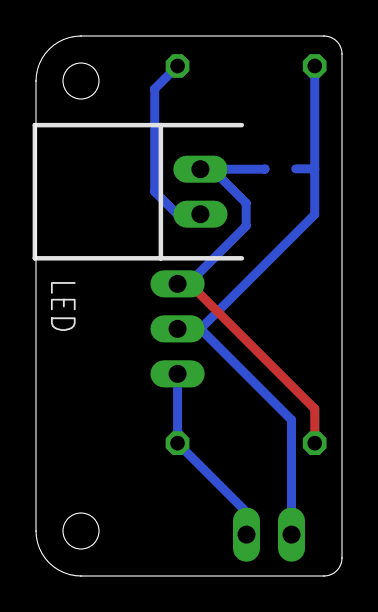
[picture p18: board ball_catch_unit_front.brd from above]

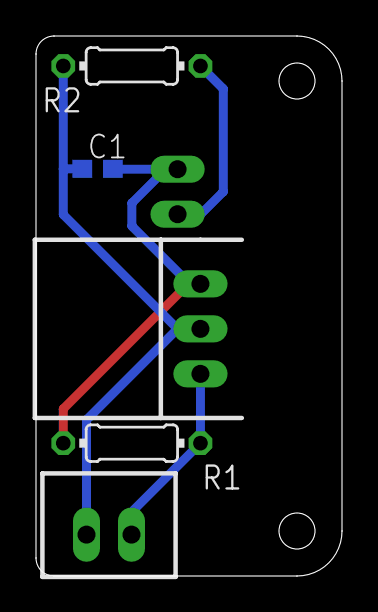
[picture p19: board ball_catch_unit_front.brd from below]

Board: 2 copper layers, 17.0 x 30.0 mm, 6 parts (5 on the bottom side), 4 nets.
