banbatakumi/RCJ2024_OPEN/Hardware/Curcuit/ui/ui.brd

## EAGLE design Hardware/Curcuit/ui/ui.brd (2025-04-20)

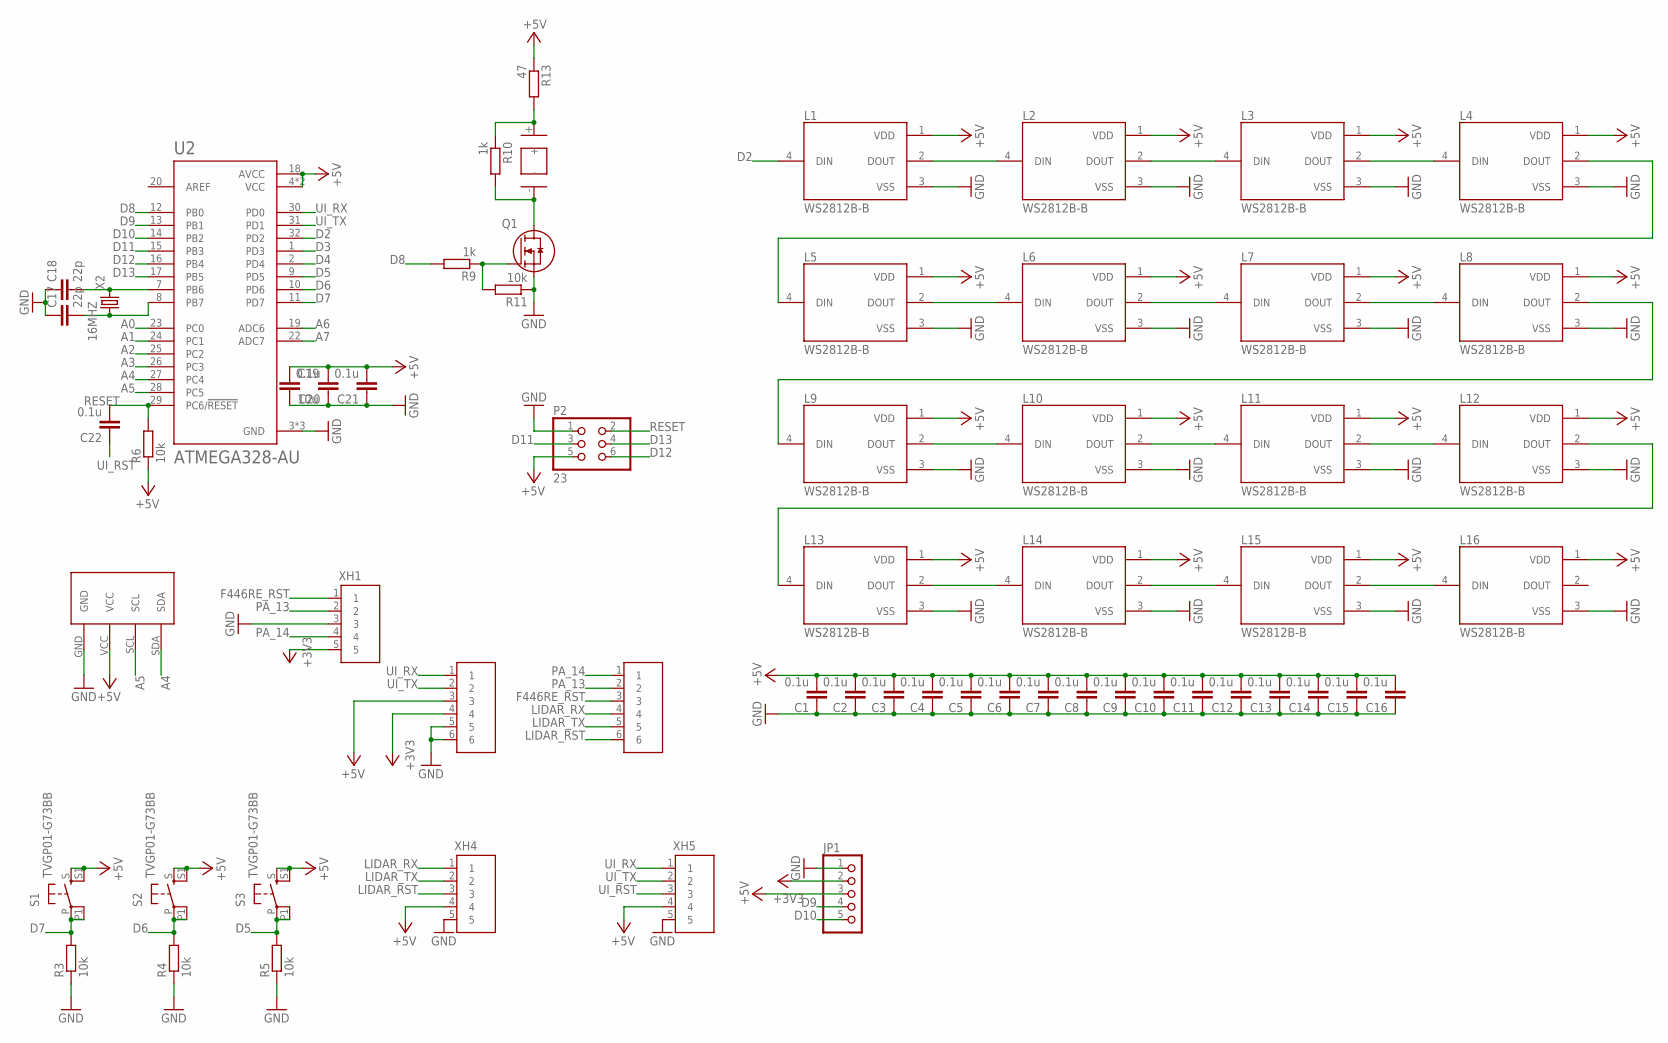
[picture p20: schematic ui.sch]

Parts:
B1: PKLCS1212E4001-R1
C1, C2, C3, C4, C5, C6, C7, C8, C9, C10, C11, C12, C13, C14, C15, C16, C20, C21, C22: 0.1u; C0603
C17, C18: 22p; C0603
C19: 10u; C0805
JP1: PINHD-1X5; 1X05
L1, L2, L3, L4, L5, L6, L7, L8, L9, L10, L11, L12, L13, L14, L15, L16: WS2812B-B; LED_WS2812B-B
P2: 23; 2*3
Q1: NP52N06SLG; TO230P1040X230-3N
R3, R4, R5, R6, R11: 10k; 0204/5
R9, R10: 1k; 0204/5
R13: 47; 0204/5
S1, S2, S3: TVGP01-G73BB
U1: SSD1306
U2: ATMEGA328-AU; QFP80P900X900X120-32N
X2: 16MHZ
XH1, XH4, XH5: S5B
XH2, XH3: S6B

Connections:
+3V3: JP1.2, XH1.5, XH2.4
+5V: C1.2, C2.2, C3.2, C4.2, C5.2, C6.2, C7.2, C8.2, C9.2, C10.2, C11.2, C12.2, C13.2, C14.2, C15.2, C16.2, C19.1, C20.2, C21.2, JP1.3, L1.1 (VDD), L2.1 (VDD), L3.1 (VDD), L4.1 (VDD), L5.1 (VDD), L6.1 (VDD), L7.1 (VDD), L8.1 (VDD), L9.1 (VDD), L10.1 (VDD), L11.1 (VDD), L12.1 (VDD), L13.1 (VDD), L14.1 (VDD), L15.1 (VDD), L16.1 (VDD), P2.5, R6.1, R13.1, S1.S, S1.S1, S2.S, S2.S1, S3.S, S3.S1, U1.VCC, U2.4 (VCC), U2.6 (VCC), U2.18 (AVCC), XH2.3, XH4.4, XH5.4
A0: U2.23 (PC0)
A1: U2.24 (PC1)
A2: U2.25 (PC2)
A3: U2.26 (PC3)
A4: U1.SDA, U2.27 (PC4)
A5: U1.SCL, U2.28 (PC5)
A6: U2.19 (ADC6)
A7: U2.22 (ADC7)
D2: L1.4 (DIN), U2.32 (PD2)
D3: U2.1 (PD3)
D4: U2.2 (PD4)
D5: R5.2, S3.P, S3.P1, U2.9 (PD5)
D6: R4.2, S2.P, S2.P1, U2.10 (PD6)
D7: R3.2, S1.P, S1.P1, U2.11 (PD7)
D8: R9.2, U2.12 (PB0)
D9: JP1.4, U2.13 (PB1)
D10: JP1.5, U2.14 (PB2)
D11: P2.3, U2.15 (PB3)
D12: P2.6, U2.16 (PB4)
D13: P2.4, U2.17 (PB5)
F446RE_RST: XH1.1, XH3.3
GND: C1.1, C2.1, C3.1, C4.1, C5.1, C6.1, C7.1, C8.1, C9.1, C10.1, C11.1, C12.1, C13.1, C14.1, C15.1, C16.1, C17.1, C18.1, C19.2, C20.1, C21.1, JP1.1, L1.3 (VSS), L2.3 (VSS), L3.3 (VSS), L4.3 (VSS), L5.3 (VSS), L6.3 (VSS), L7.3 (VSS), L8.3 (VSS), L9.3 (VSS), L10.3 (VSS), L11.3 (VSS), L12.3 (VSS), L13.3 (VSS), L14.3 (VSS), L15.3 (VSS), L16.3 (VSS), P2.1, Q1.S, R3.1, R4.1, R5.1, R11.1, U1.GND, U2.3 (GND), U2.5 (GND), U2.21 (GND), XH1.3, XH2.5, XH2.6, XH4.5, XH5.5
LIDAR_RST: XH3.6, XH4.3
LIDAR_RX: XH3.4, XH4.1
LIDAR_TX: XH3.5, XH4.2
unnamed: C18.2, U2.7 (PB6), X2.P$2 (2)
unnamed: C17.2, U2.8 (PB7), X2.P$1 (1)
unnamed: B1.-, Q1.D, R10.2
unnamed: L1.2 (DOUT), L2.4 (DIN)
unnamed: L2.2 (DOUT), L3.4 (DIN)
unnamed: L3.2 (DOUT), L4.4 (DIN)
unnamed: L4.2 (DOUT), L5.4 (DIN)
unnamed: L5.2 (DOUT), L6.4 (DIN)
unnamed: L6.2 (DOUT), L7.4 (DIN)
unnamed: L7.2 (DOUT), L8.4 (DIN)
unnamed: L8.2 (DOUT), L9.4 (DIN)
unnamed: Q1.G, R9.1, R11.2
unnamed: L9.2 (DOUT), L10.4 (DIN)
unnamed: L10.2 (DOUT), L11.4 (DIN)
unnamed: L11.2 (DOUT), L12.4 (DIN)
unnamed: L12.2 (DOUT), L13.4 (DIN)
unnamed: L13.2 (DOUT), L14.4 (DIN)
unnamed: L14.2 (DOUT), L15.4 (DIN)
unnamed: L15.2 (DOUT), L16.4 (DIN)
unnamed: B1.+, R10.1, R13.2
PA_13: XH1.2, XH3.2
PA_14: XH1.4, XH3.1
RESET: C22.2, P2.2, R6.2, U2.29 (PC6/!RESET)
UI_RST: C22.1, XH5.3
UI_RX: U2.30 (PD0), XH2.1, XH5.1
UI_TX: U2.31 (PD1), XH2.2, XH5.2

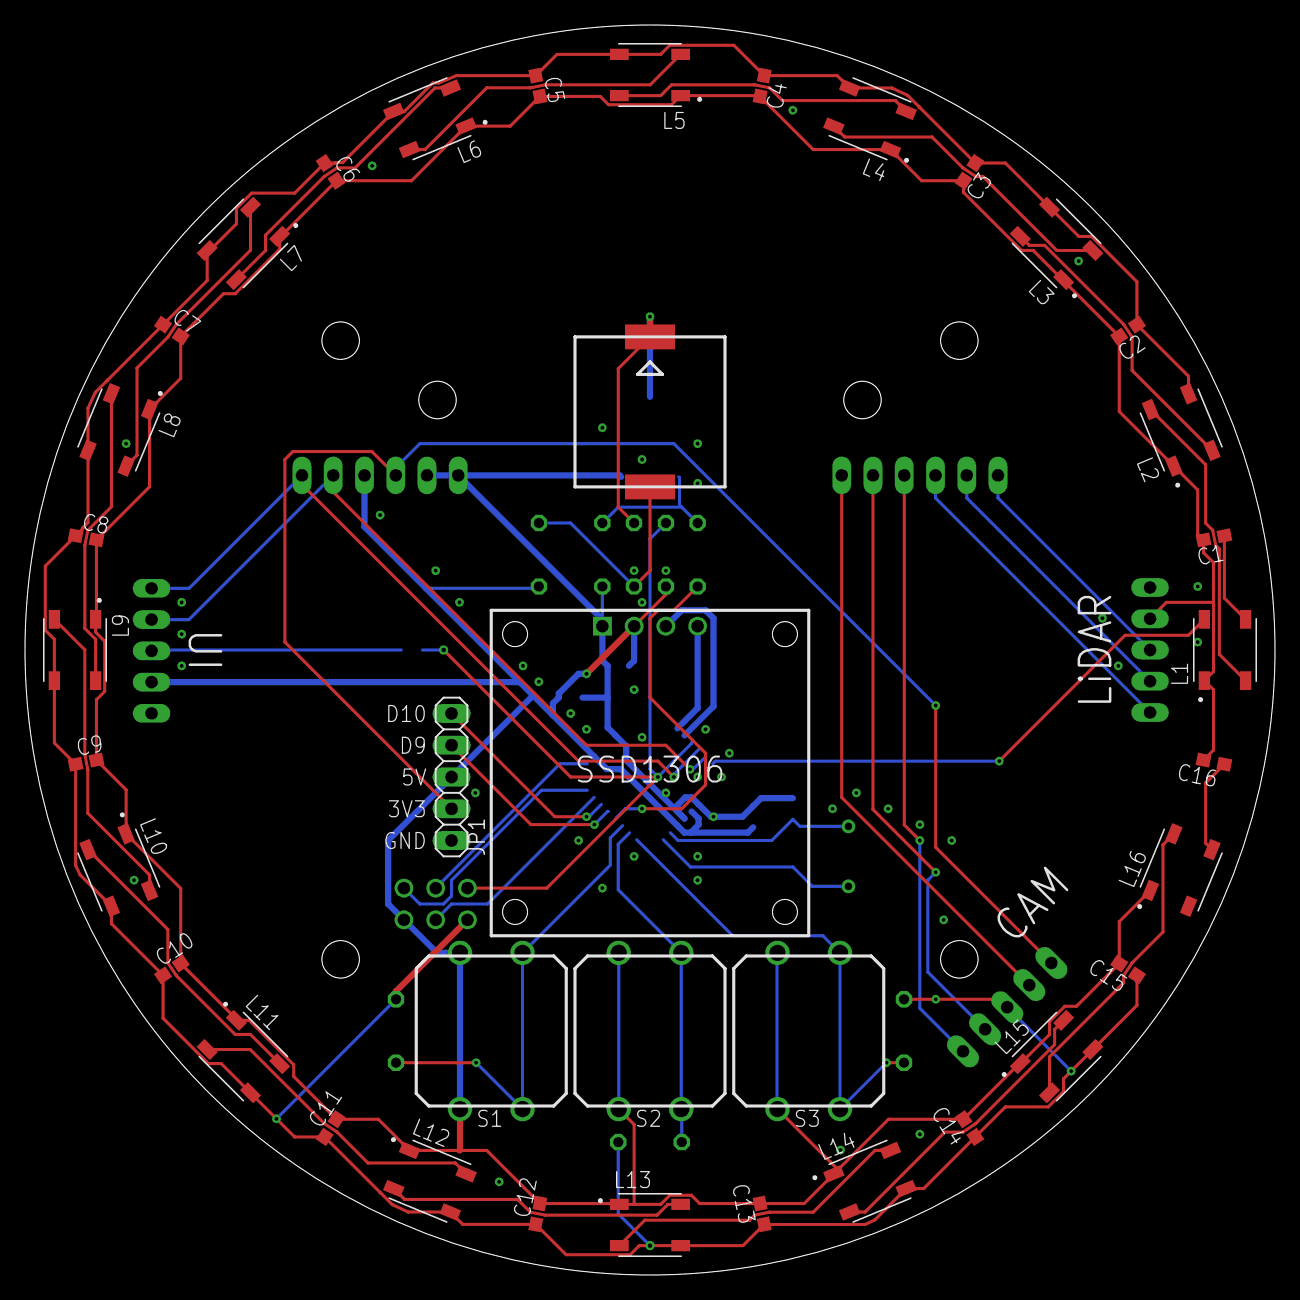
[picture p21: board ui.brd from above]

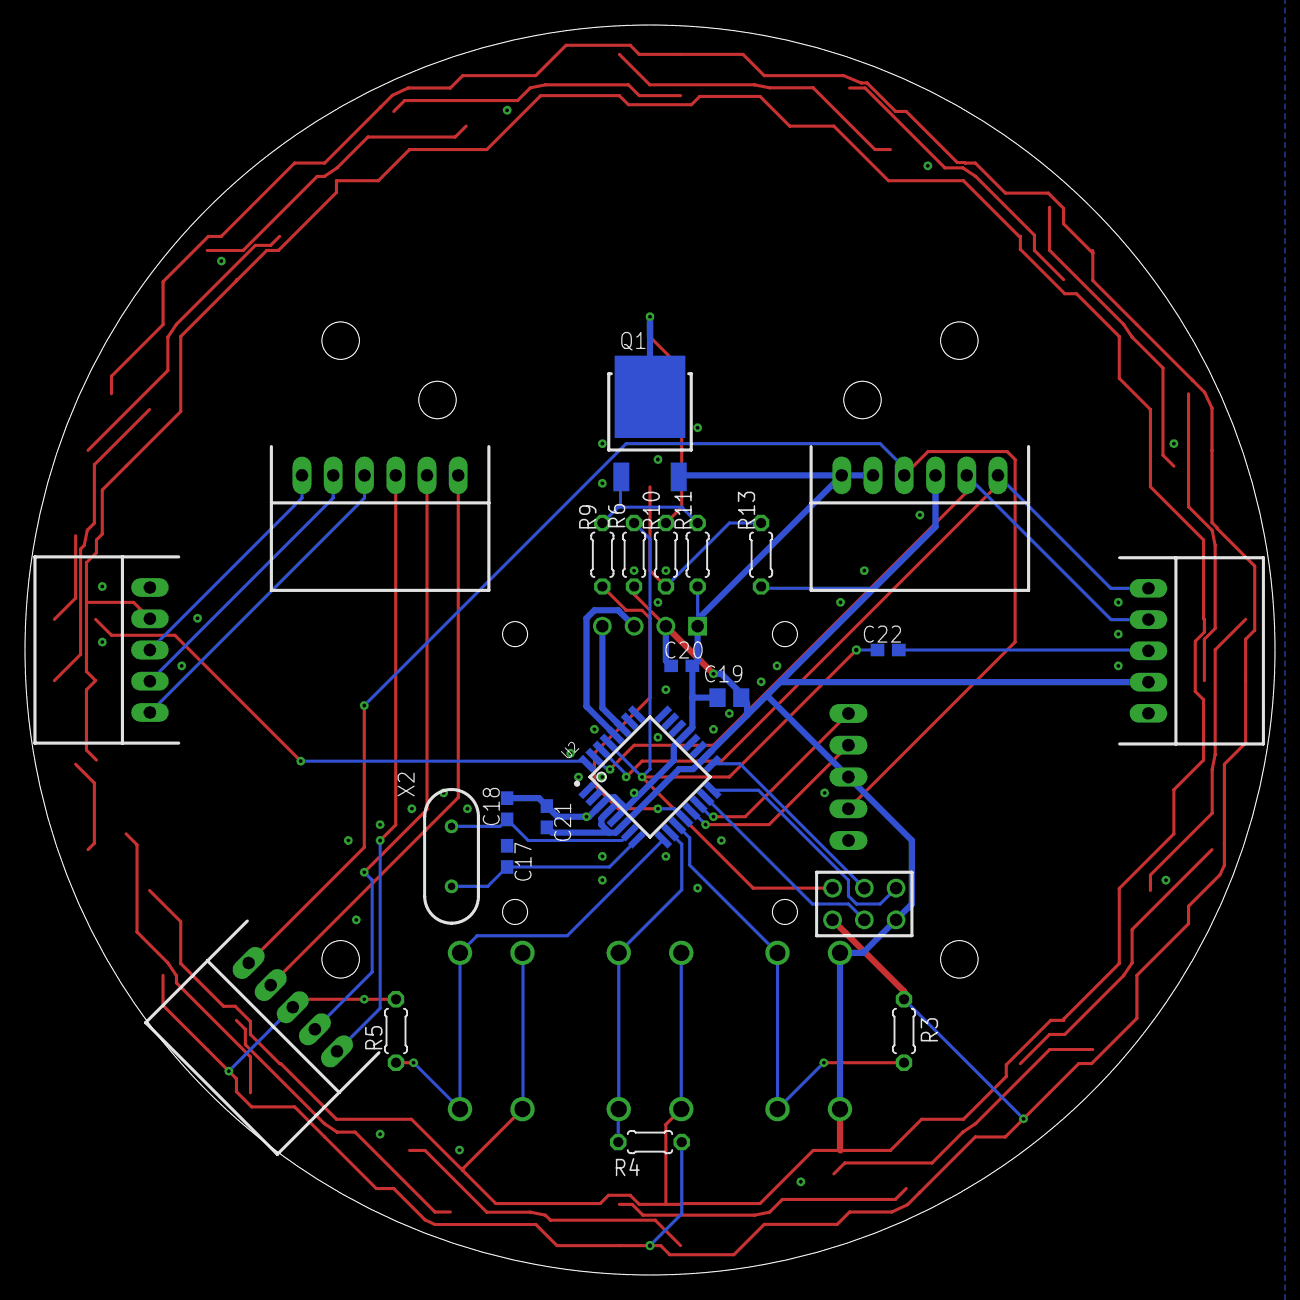
[picture p22: board ui.brd from below]

Board: 2 copper layers, 100.0 x 100.0 mm, 61 parts (23 on the bottom side), 45 nets.
