banbatakumi/RCJ2024_OPEN/Hardware/Curcuit/IR/MD/MD.brd

## EAGLE design Hardware/Curcuit/IR/MD/MD.brd (2025-04-20)

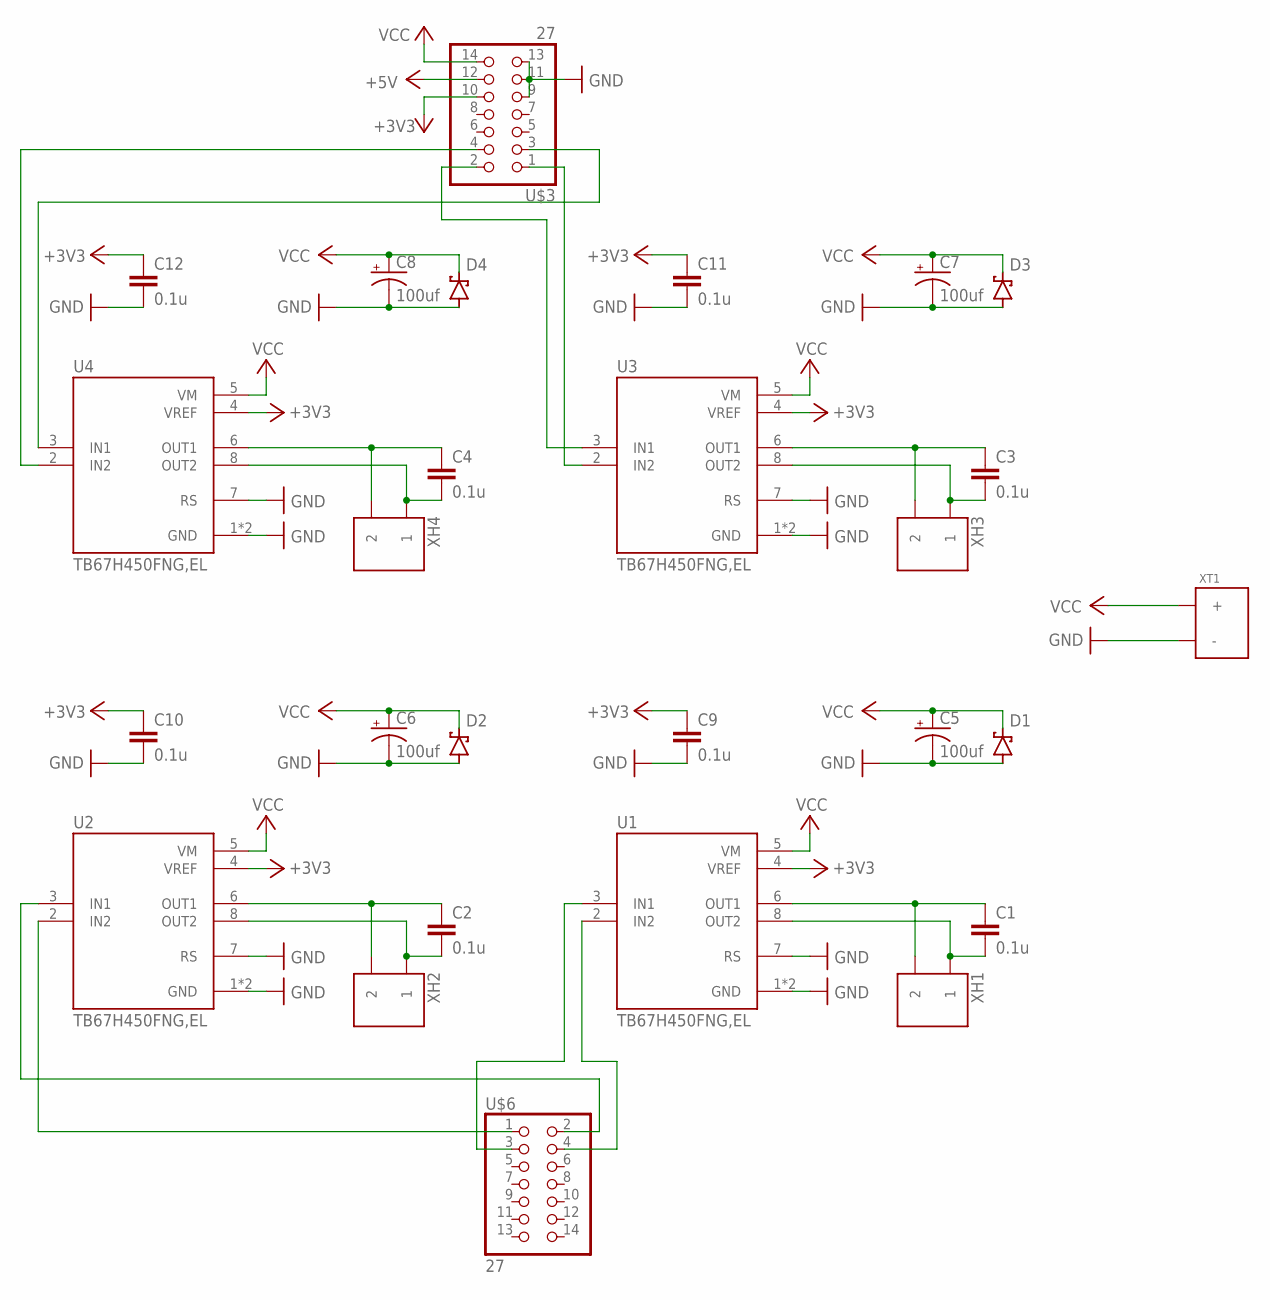
[picture p23: schematic MD.sch]

Parts:
C1, C2, C3, C4, C9, C10, C11, C12: 0.1u; C0603
C5, C6, C7, C8: 100uf; MH5
D1, D2, D3, D4: SS2040FL; SOD123FL
U1, U2, U3, U4: TB67H450FNG,EL; SOIC127P599X175-9N
U$3, U$6: 27; 2*7
XH1, XH2, XH3, XH4: S2B
XT1: XT30PW-M

Connections:
+3V3: C9.1, C10.1, C11.1, C12.1, U1.4 (VREF), U2.4 (VREF), U3.4 (VREF), U4.4 (VREF), U$3.10
+5V: U$3.12
GND: C5.-, C6.-, C7.-, C8.-, C9.2, C10.2, C11.2, C12.2, D1.A, D2.A, D3.A, D4.A, U1.1 (GND), U1.7 (RS), U1.9 (GND), U2.1 (GND), U2.7 (RS), U2.9 (GND), U3.1 (GND), U3.7 (RS), U3.9 (GND), U4.1 (GND), U4.7 (RS), U4.9 (GND), U$3.9, U$3.11, U$3.13, XT1.-
unnamed: U1.3 (IN1), U$6.3
unnamed: C1.1, U1.6 (OUT1), XH1.2
unnamed: C1.2, U1.8 (OUT2), XH1.1
unnamed: C2.1, U2.6 (OUT1), XH2.2
unnamed: U1.2 (IN2), U$6.4
unnamed: C2.2, U2.8 (OUT2), XH2.1
unnamed: C3.1, U3.6 (OUT1), XH3.2
unnamed: C3.2, U3.8 (OUT2), XH3.1
unnamed: C4.1, U4.6 (OUT1), XH4.2
unnamed: C4.2, U4.8 (OUT2), XH4.1
unnamed: U2.3 (IN1), U$6.2
unnamed: U2.2 (IN2), U$6.1
unnamed: U3.2 (IN2), U$3.1
unnamed: U3.3 (IN1), U$3.2
unnamed: U4.2 (IN2), U$3.4
unnamed: U4.3 (IN1), U$3.3
VCC: C5.+, C6.+, C7.+, C8.+, D1.C, D2.C, D3.C, D4.C, U1.5 (VM), U2.5 (VM), U3.5 (VM), U4.5 (VM), U$3.14, XT1.+

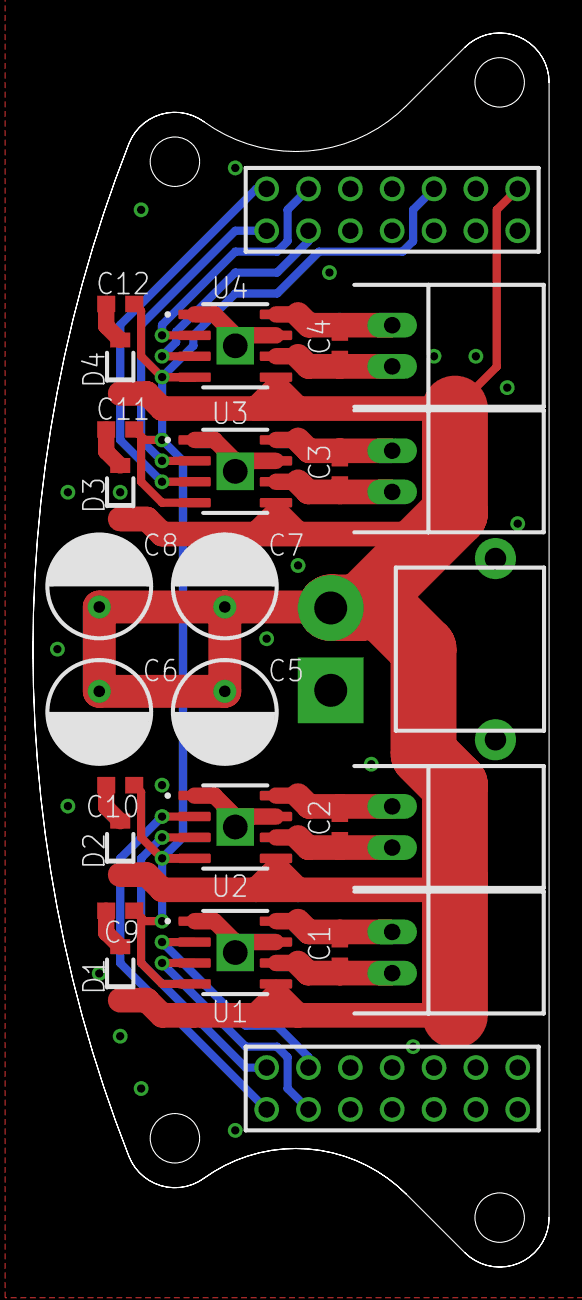
[picture p24: board MD.brd from above]

Board: 2 copper layers, 31.3 x 74.9 mm, 27 parts (0 on the bottom side), 19 nets.
