banbatakumi/RCJ2024_OPEN/Hardware/Curcuit/new_ball_catch/ball_catch_order/ball_catch_order.brd

## EAGLE design Hardware/Curcuit/new_ball_catch/ball_catch_order/ball_catch_order.brd (2025-04-20)

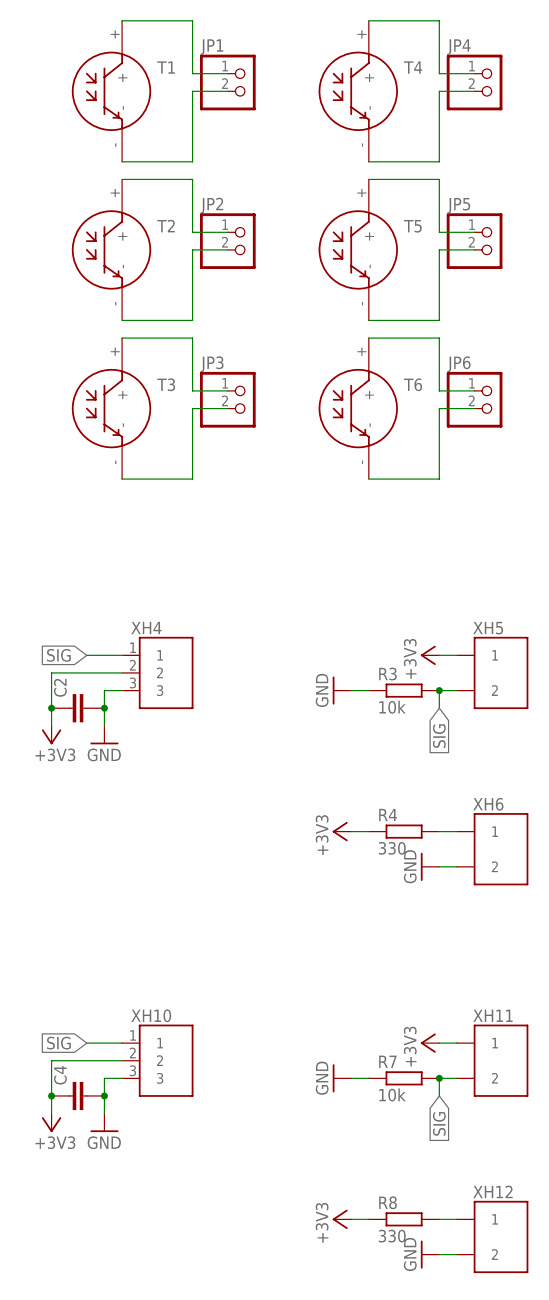
[picture p25: schematic ball_catch_order.sch]

Parts:
C2, C4: C-EUC0603; C0603
JP1, JP2, JP3, JP4, JP5, JP6: PINHD-1X2; 1X02
R3, R7: 10k; 0204/7
R4, R8: 330; 0204/7
T1, T2, T3, T4, T5, T6: NJL7302L-F3
XH4, XH10: S3B
XH5, XH11: 2B
XH6, XH12: S2B

Connections:
+3V3: C2.1, C4.1, R4.1, R8.1, XH4.2, XH5.1, XH10.2, XH11.1
GND: C2.2, C4.2, R3.1, R7.1, XH4.3, XH6.2, XH10.3, XH12.2
unnamed: JP1.1, T1.+
unnamed: JP1.2, T1.-
unnamed: JP2.1, T2.+
unnamed: JP2.2, T2.-
unnamed: JP3.1, T3.+
unnamed: JP3.2, T3.-
unnamed: JP4.1, T4.+
unnamed: JP4.2, T4.-
unnamed: JP5.1, T5.+
unnamed: JP5.2, T5.-
unnamed: JP6.1, T6.+
unnamed: JP6.2, T6.-
unnamed: R4.2, XH6.1
unnamed: R8.2, XH12.1
SIG: R3.2, R7.2, XH4.1, XH5.2, XH10.1, XH11.2
