banbatakumi/RCJ2024_OPEN/Hardware/Curcuit/new_ball_catch/ball_catch_order/ball_catch_order.brd

## EAGLE design Hardware/Curcuit/new_ball_catch/ball_catch_order/ball_catch_order.brd (continued)

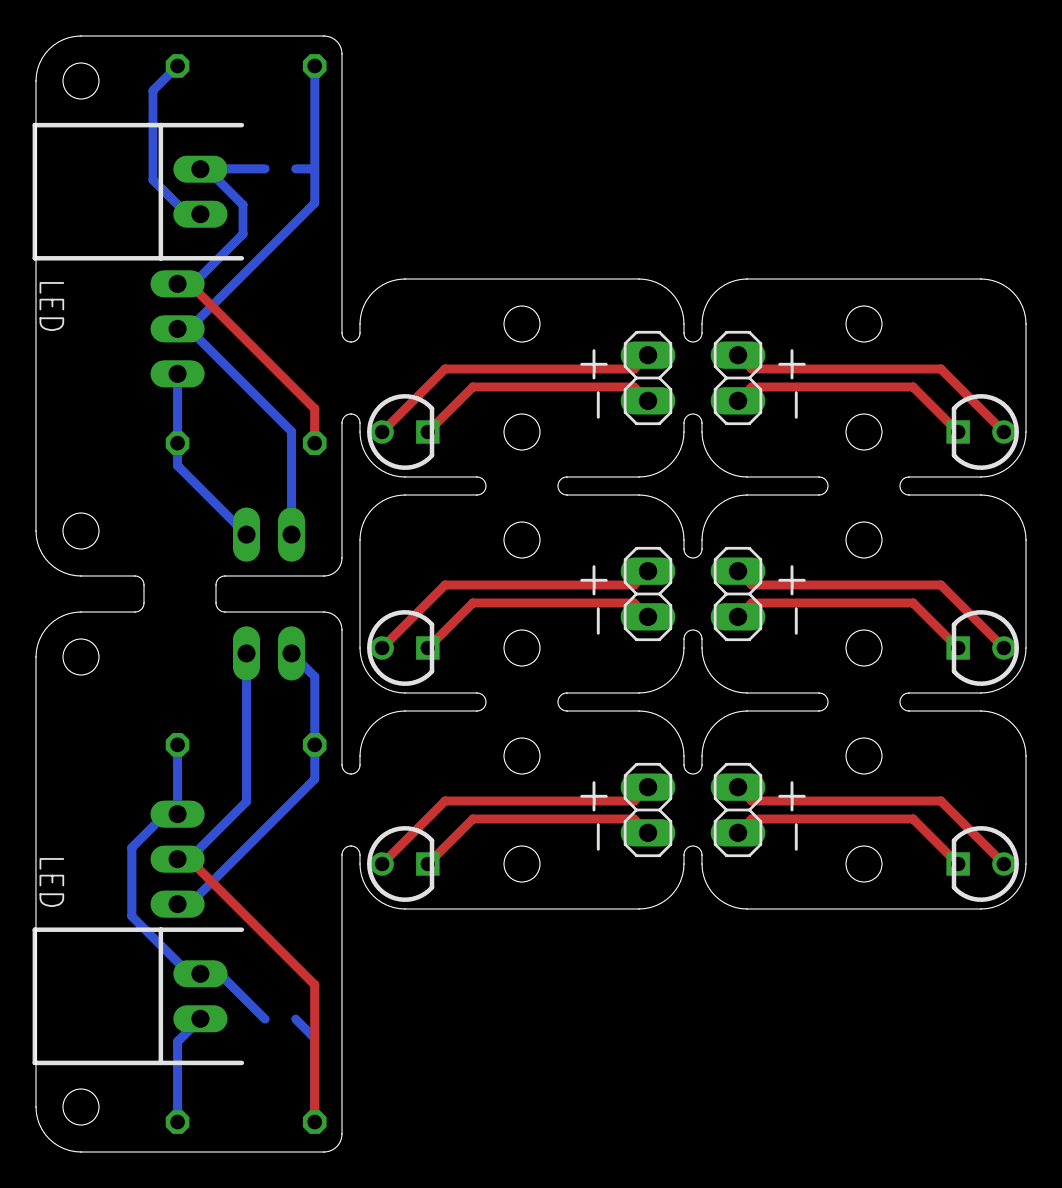
[picture p26: board ball_catch_order.brd from above]

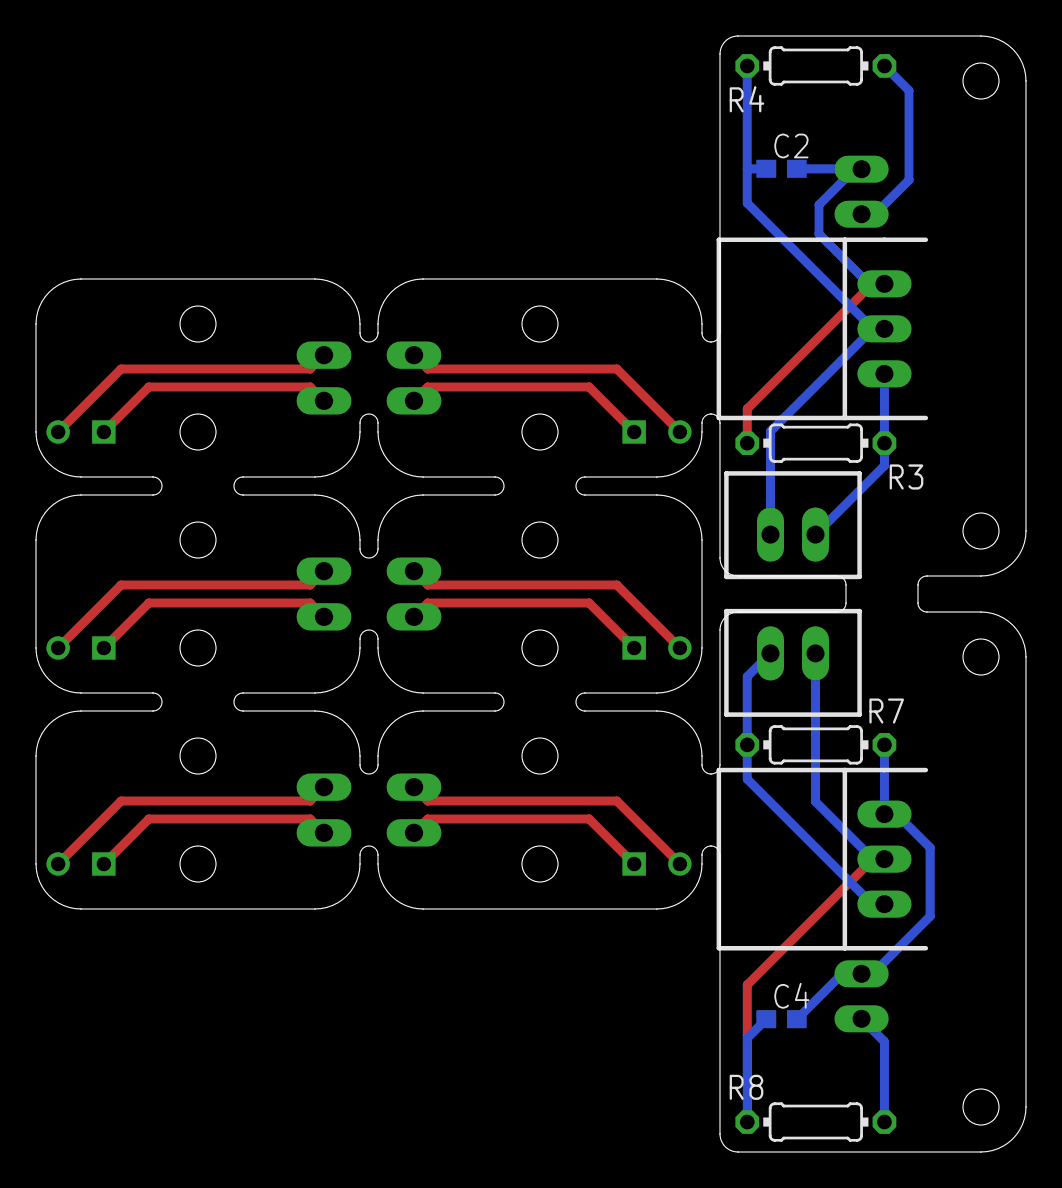
[picture p27: board ball_catch_order.brd from below]

Board: 2 copper layers, 55.0 x 62.0 mm, 24 parts (10 on the bottom side), 17 nets.
