banbatakumi/RCJ2024_OPEN/Hardware/Curcuit/kicker_ver/kickerv3/kickerv3.brd

## EAGLE design Hardware/Curcuit/kicker_ver/kickerv3/kickerv3.brd (2025-04-20)

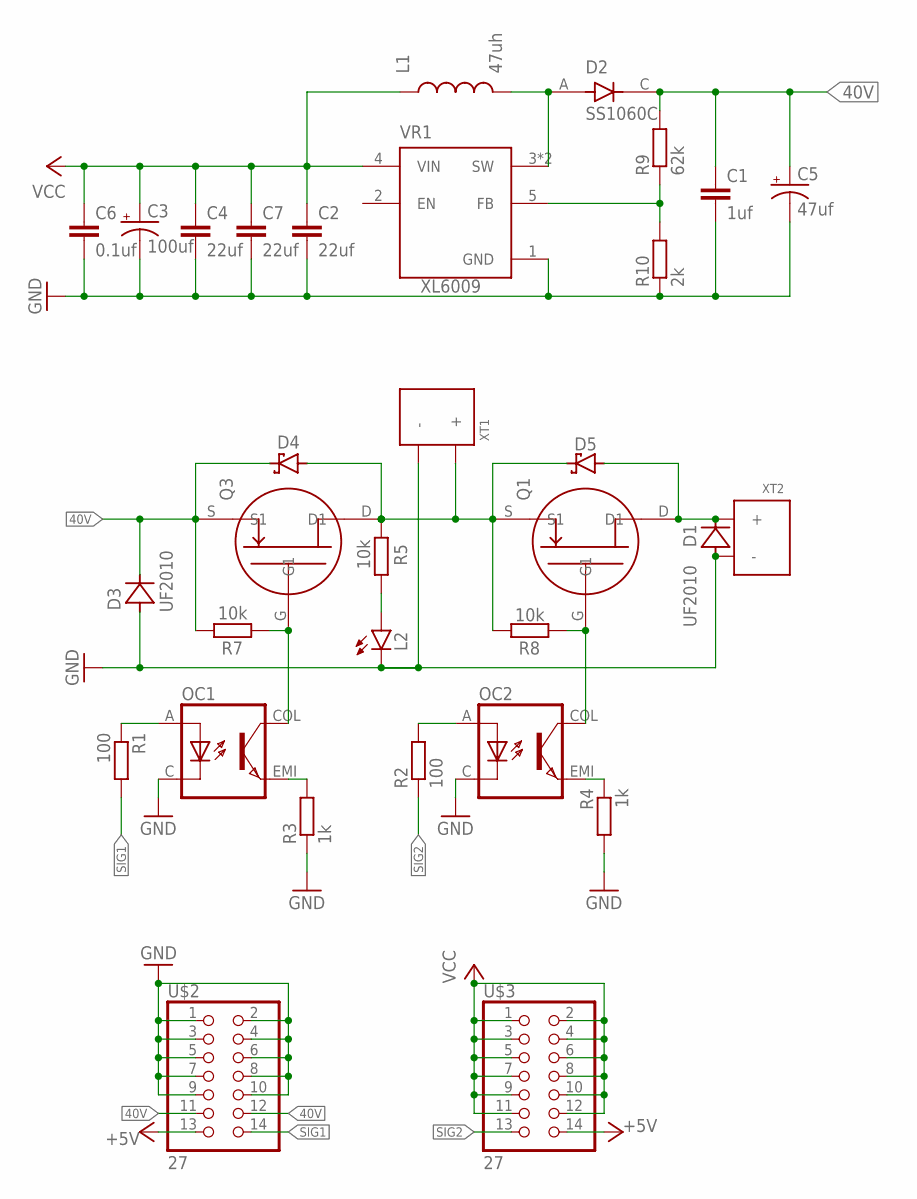
[picture p28: schematic kickerv3.sch]

Parts:
C1: 1uf; C1206
C2, C4, C7: 22uf; C0805
C3: 100uf; MH5
C5: 47uf; VZ1H470ME077000CE0
C6: 0.1uf; C0603
D1, D3: UF2010
D2: SS1060C; DIOSC6959X240
D4, D5: 1SS178
L1: 47uh; MDE1040-470M
L2: SML-E12P8WT86; LED_SML-LXFM0603SIC-TR
OC1, OC2: TL293(GB); SOIC127P700X230-4N
Q1, Q3: TJ60S04M3L; DPACK
R1, R2: 100; R0603
R3, R4: 1k; R0603
R5, R7, R8: 10k; R0603
R9: 62k; R0603
R10: 2k; R0603
U$2, U$3: 27; 2*7
VR1: XL6009; DPAK170P1435X465-6N
XT1, XT2: XT30PW-F

Connections:
40V: C1.1, C5.+, D2.C, D3.C, D4.C, Q3.S (S1), R7.1, R9.2, U$2.11, U$2.12
+5V: U$2.13, U$3.14
GND: C1.2, C2.2, C3.-, C4.2, C5.-, C6.2, C7.2, D1.A, D3.A, L2.C, OC1.C, OC2.C, R3.1, R4.2, R10.1, U$2.1, U$2.2, U$2.3, U$2.4, U$2.5, U$2.6, U$2.7, U$2.8, U$2.9, U$2.10, VR1.1 (GND), XT1.-, XT2.-
unnamed: D4.A, D5.C, Q1.S (S1), Q3.D (D1), R5.2, R8.1, XT1.+
unnamed: OC1.COL, Q3.G (G1), R7.2
unnamed: OC1.EMI, R3.2
unnamed: R9.1, R10.2, VR1.5 (FB)
unnamed: OC1.A, R1.1
unnamed: OC2.A, R2.2
unnamed: OC2.EMI, R4.1
unnamed: D1.C, D5.A, Q1.D (D1), XT2.+
unnamed: OC2.COL, Q1.G (G1), R8.2
unnamed: D2.A, L1.P$2 (2), VR1.3 (SW), VR1.6 (SW)
unnamed: L2.A, R5.1
SIG1: R1.2, U$2.14
SIG2: R2.1, U$3.13
VCC: C2.1, C3.+, C4.1, C6.1, C7.1, L1.P$1 (1), U$3.1, U$3.2, U$3.3, U$3.4, U$3.5, U$3.6, U$3.7, U$3.8, U$3.9, U$3.10, U$3.11, U$3.12, VR1.4 (VIN)

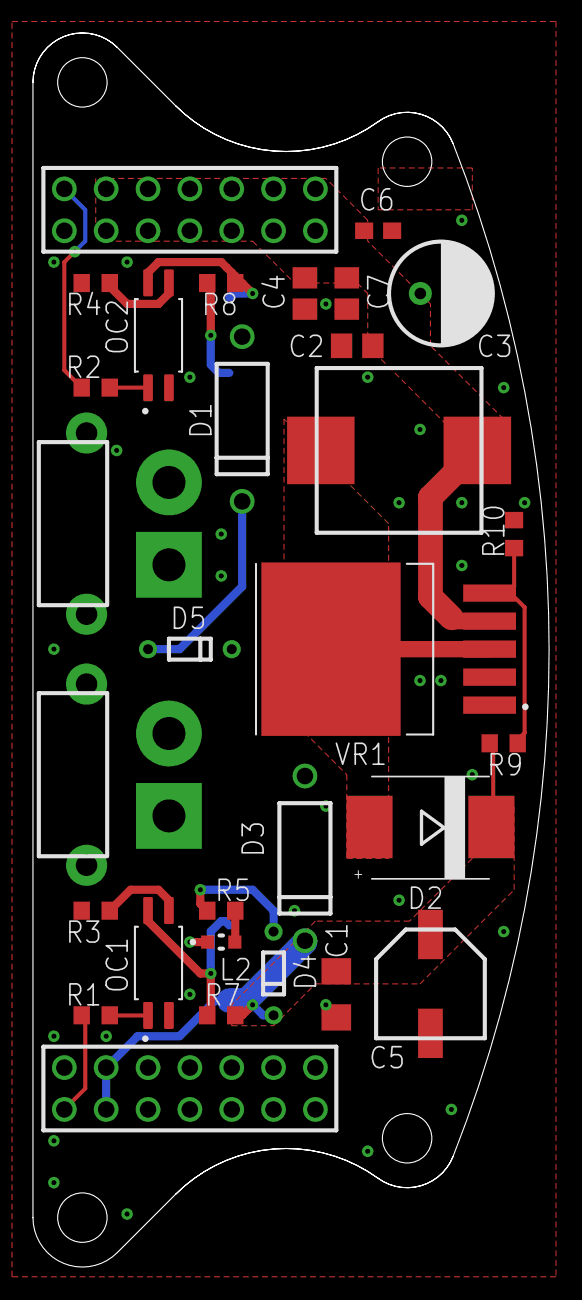
[picture p29: board kickerv3.brd from above]

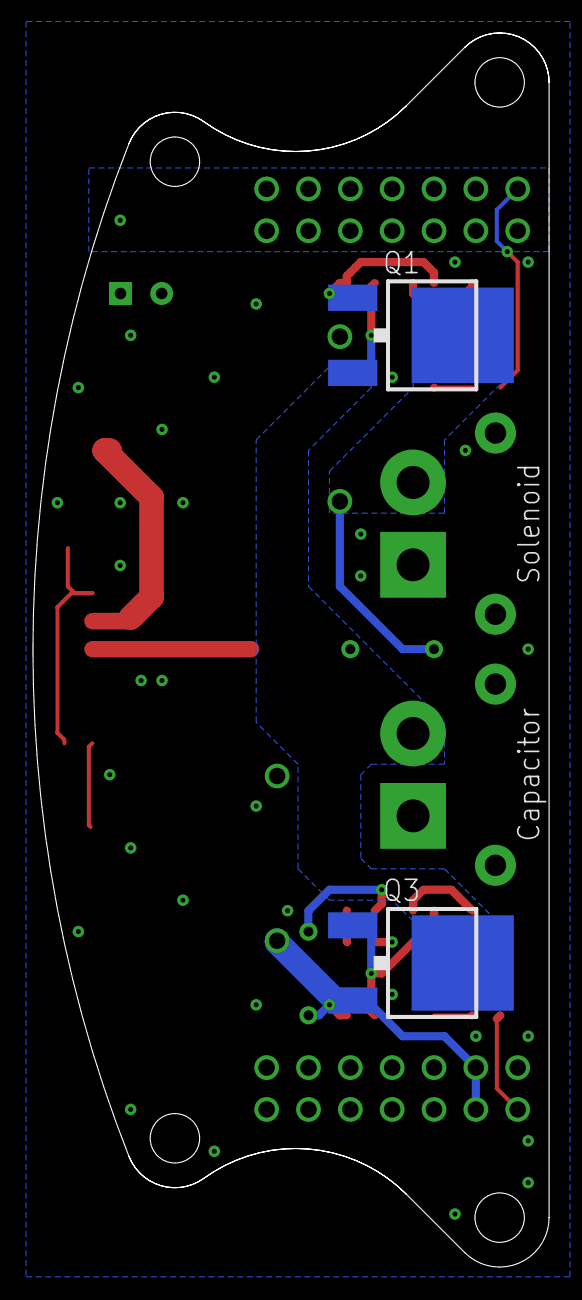
[picture p30: board kickerv3.brd from below]

Board: 2 copper layers, 31.3 x 74.9 mm, 32 parts (2 on the bottom side), 17 nets.
