banbatakumi/RCJ2024_OPEN/Hardware/Curcuit/supply/supply.brd

## EAGLE design Hardware/Curcuit/supply/supply.brd (2025-04-20)

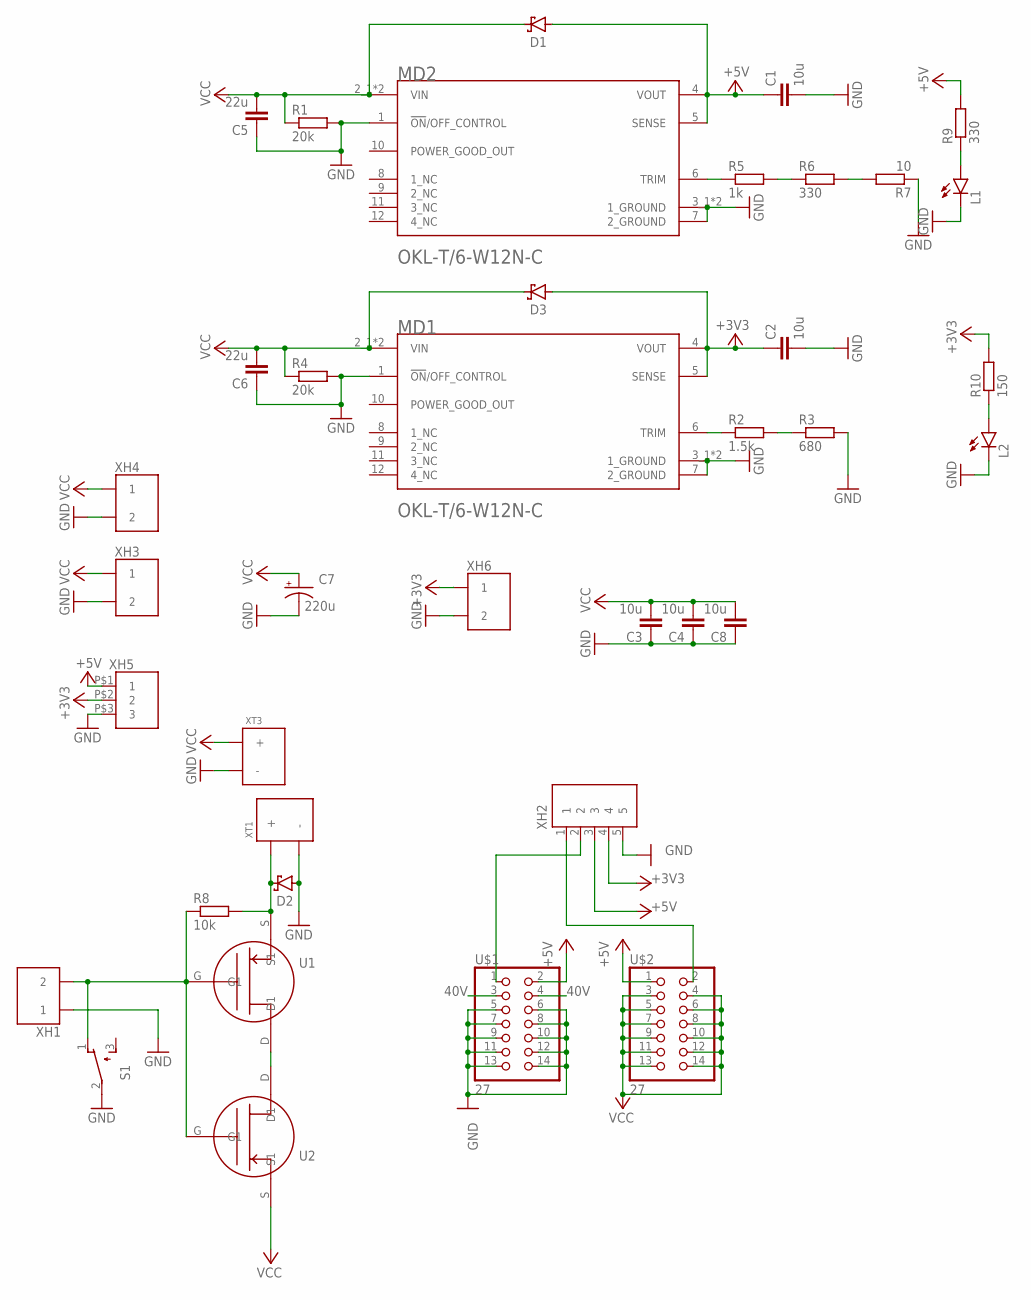
[picture p31: schematic supply.sch]

Parts:
C1, C2, C3, C4, C8: 10u; C0805
C5, C6: 22u; C0805
C7: 220u; CAPAE830X1080N
D1, D2, D3: SS2040FL; SOD123FL
L1, L2: SML-E12P8WT86; LED_SML-LXFM0603SIC-TR
MD1, MD2: OKL-T/6-W12N-CMURATA_OKL-T-6-W12N-C_0_0; MURATA_OKL-T-6-W12N-C_0
R1, R4: 20k; R0603
R2: 1.5k; R0603
R3: 680; R0603
R5: 1k; R0603
R6, R9: 330; R0603
R7: 10; R0603
R8: 10k; R0603
R10: 150; R0603
S1: SS-12SDP2
U1, U2: TJ60S04M3L; DPACK
U$1, U$2: 27; 2*7
XH1, XH3, XH4, XH6: 2B
XH2: 5B
XH5: 3B
XT1: XT60U-M
XT3: XT30U-M

Connections:
40V: U$1.3, U$1.4
+3V3: C2.1, D3.A, MD1.4 (VOUT), MD1.5 (SENSE), R10.2, XH2.4, XH5.P$2 (2), XH6.P$1 (1)
+5V: C1.1, D1.A, MD2.4 (VOUT), MD2.5 (SENSE), R9.2, U$1.2, U$2.1, XH2.3, XH5.P$1 (1)
GND: C1.2, C2.2, C3.1, C4.1, C5.1, C6.1, C7.-, C8.1, D2.A, L1.C, L2.C, MD1.1 (!ON!/OFF_CONTROL), MD1.3_1 (1_GROUND), MD1.3_2 (1_GROUND), MD1.7 (2_GROUND), MD2.1 (!ON!/OFF_CONTROL), MD2.3_1 (1_GROUND), MD2.3_2 (1_GROUND), MD2.7 (2_GROUND), R1.2, R3.2, R4.2, R7.1, S1.2, U$1.5, U$1.6, U$1.7, U$1.8, U$1.9, U$1.10, U$1.11, U$1.12, U$1.13, U$1.14, XH1.P$1 (1), XH2.5, XH3.P$2 (2), XH4.P$2 (2), XH5.P$3 (3), XH6.P$2 (2), XT1.-, XT3.-
unnamed: MD1.6 (TRIM), R2.1
unnamed: R2.2, R3.1
unnamed: MD2.6 (TRIM), R5.1
unnamed: R5.2, R6.1
unnamed: R6.2, R7.2
unnamed: R8.1, S1.1, U1.G (G1), U2.G (G1), XH1.P$2 (2)
unnamed: D2.C, R8.2, U1.S (S1), XT1.+
unnamed: U1.D (D1), U2.D (D1)
unnamed: U$1.1, XH2.2
unnamed: U$2.2, XH2.1
unnamed: L1.A, R9.1
unnamed: L2.A, R10.1
VCC: C3.2, C4.2, C5.2, C6.2, C7.+, C8.2, D1.C, D3.C, MD1.2_1 (VIN), MD1.2_2 (VIN), MD2.2_1 (VIN), MD2.2_2 (VIN), R1.1, R4.1, U2.S (S1), U$2.3, U$2.4, U$2.5, U$2.6, U$2.7, U$2.8, U$2.9, U$2.10, U$2.11, U$2.12, U$2.13, U$2.14, XH3.P$1 (1), XH4.P$1 (1), XT3.+

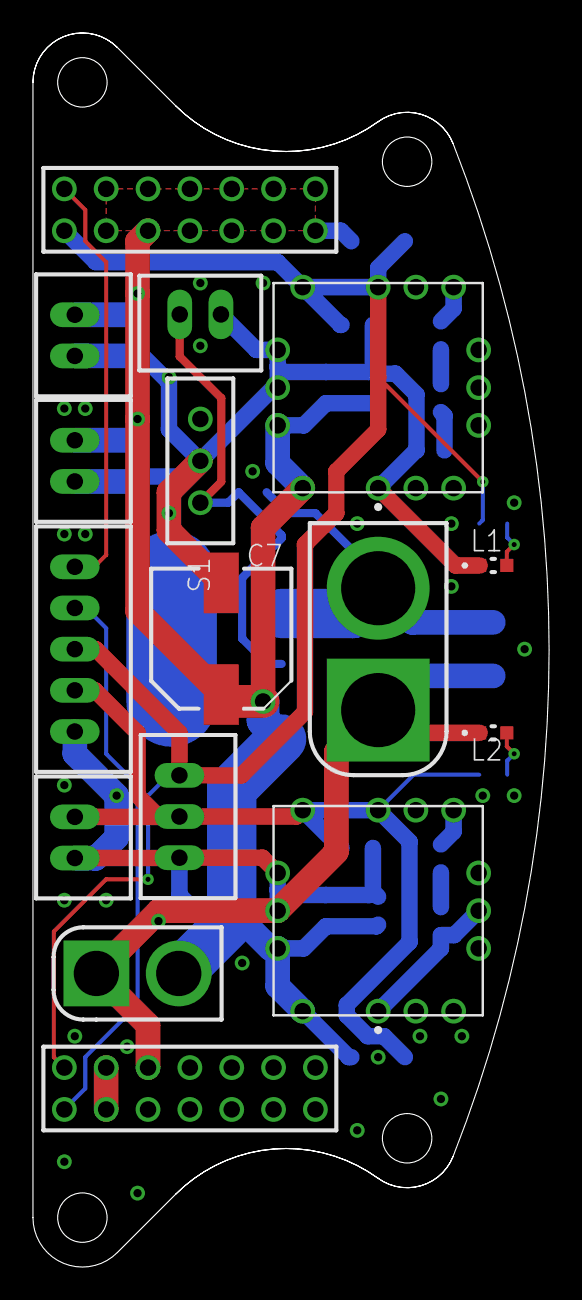
[picture p32: board supply.brd from above]

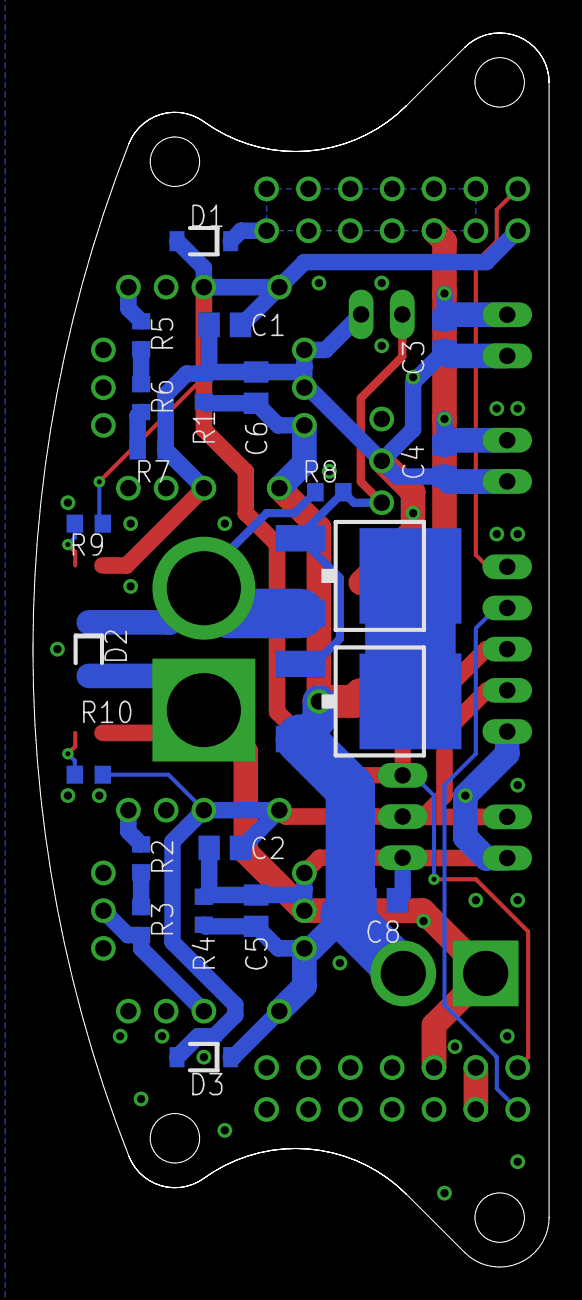
[picture p33: board supply.brd from below]

Board: 2 copper layers, 31.3 x 74.9 mm, 38 parts (22 on the bottom side), 17 nets.
