banbatakumi/RCJ2024_OPEN/Hardware/Curcuit/cam_new/cam_new.brd

## EAGLE design Hardware/Curcuit/cam_new/cam_new.brd (2025-04-20)

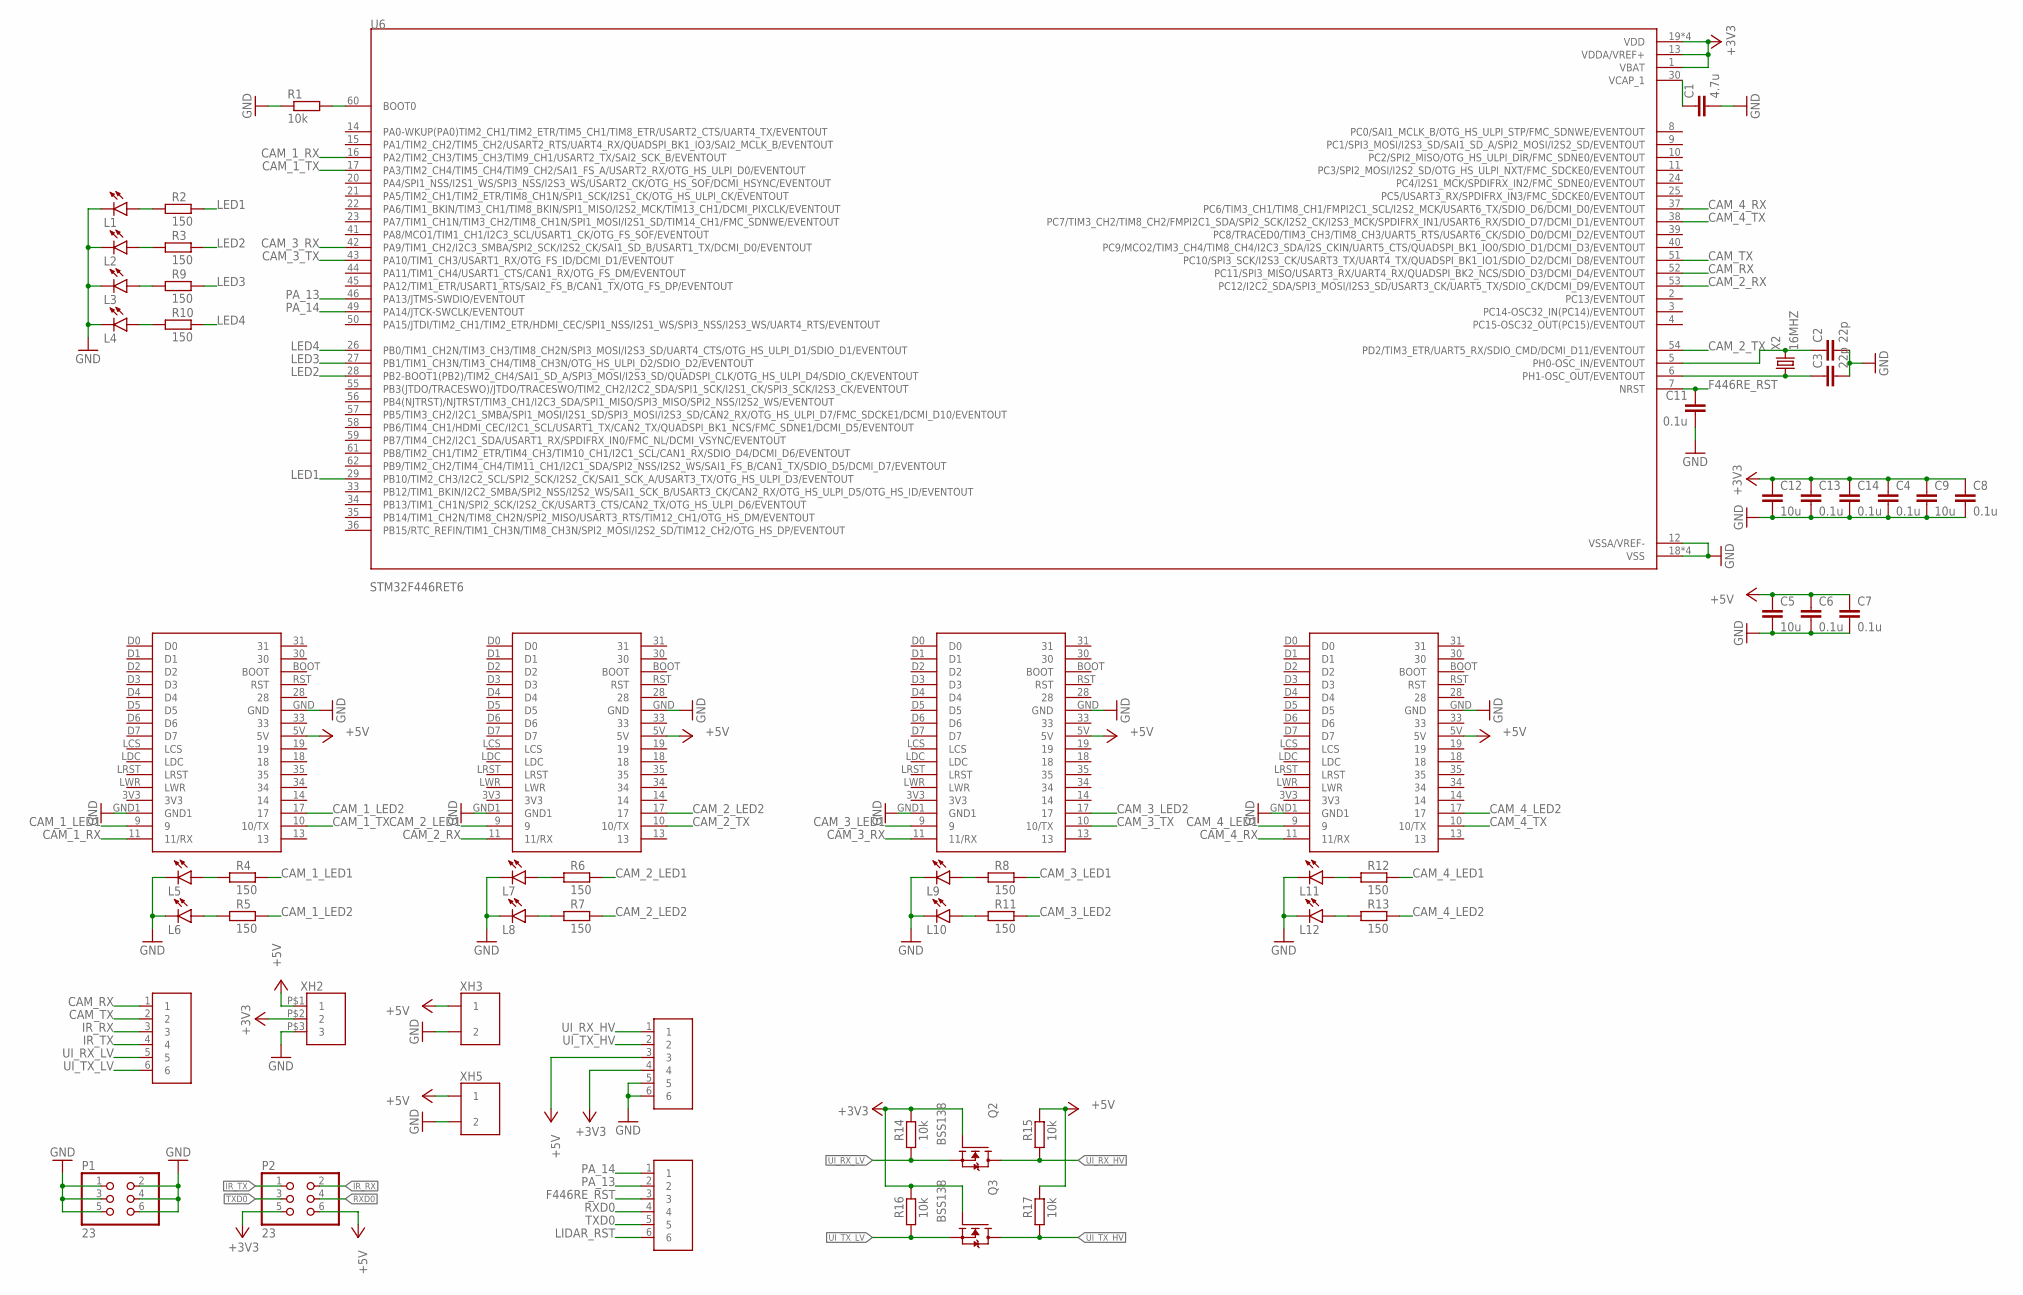
[picture p34: schematic cam_new.sch]

Parts:
C1: 4.7u; C0603
C2, C3: 22p; C0603
C4, C6, C7, C8, C11, C13, C14: 0.1u; C0603
C5, C9, C12: 10u; C0805
L1, L2, L3, L4, L5, L6, L7, L8, L9, L10, L11, L12: SML-E12P8WT86; LED_SML-LXFM0603SIC-TR
P1, P2: 23; 2*3
Q2, Q3: BSS138; SOT95P240X111-3N
R1, R14, R15, R16, R17: 10k; R0603
R2, R3, R4, R5, R6, R7, R8, R9, R10, R11, R12, R13: 150; R0603
U1, U2, U3, U4: M1N
U6: STM32F446RET6; QFP50P1200X1200X160-64N
X2: 16MHZ
XH1, XH4, XH6: 6B
XH2: 3B
XH3, XH5: 2B

Connections:
+3V3: C4.1, C8.1, C9.1, C12.1, C13.1, C14.1, P2.5, Q2.1 (G), Q3.1 (G), R14.2, R16.2, U6.1 (VBAT), U6.13 (VDDA/VREF+), U6.19 (VDD), U6.32 (VDD), U6.48 (VDD), U6.64 (VDD), XH2.P$2 (2), XH4.4
+5V: C5.1, C6.1, C7.1, P2.6, R15.2, R17.2, U1.5V, U2.5V, U3.5V, U4.5V, XH2.P$1 (1), XH3.P$1 (1), XH4.3, XH5.P$1 (1)
CAM_1_LED1: R4.2, U1.9
CAM_1_LED2: R5.2, U1.17
CAM_1_RX: U1.11 (11/RX), U6.16 (PA2/TIM2_CH3/TIM5_CH3/TIM9_CH1/USART2_T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)
CAM_1_TX: U1.10 (10/TX), U6.17 (PA3/TIM2_CH4/TIM5_CH4/TIM9_CH2/SAI1_FS_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)
CAM_2_LED1: R6.2, U2.9
CAM_2_LED2: R7.2, U2.17
CAM_2_RX: U2.11 (11/RX), U6.53 (PC12/I2C2_SDA/SPI3_MOSI/I2S3_SD/USART3_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)
CAM_2_TX: U2.10 (10/TX), U6.54 (PD2/TIM3_ETR/UART5_RX/SDIO_CMD/DCMI_D11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)
CAM_3_LED1: R8.2, U3.9
CAM_3_LED2: R11.2, U3.17
CAM_3_RX: U3.11 (11/RX), U6.42 (PA9/TIM1_CH2/I2C3_SMBA/SPI2_SCK/I2S2_CK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)
CAM_3_TX: U3.10 (10/TX), U6.43 (PA10/TIM1_CH3/USART1_RX/OTG_FS_ID/DCMI_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)
CAM_4_LED1: R12.2, U4.9
CAM_4_LED2: R13.2, U4.17
CAM_4_RX: U4.11 (11/RX), U6.37 (PC6/TIM3_CH1/TIM8_CH1/FMPI2C1_SCL/I2S2_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)
CAM_4_TX: U4.10 (10/TX), U6.38 (PC7/TIM3_CH2/TIM8_CH2/FMPI2C1_SDA/SPI2_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)
CAM_RX: U6.52 (PC11/SPI3_MISO/USART3_RX/UART4_RX/QUADS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), XH1.1
CAM_TX: U6.51 (PC10/SPI3_SCK/I2S3_CK/USART3_TX/UART4_T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), XH1.2
F446RE_RST: C11.1, U6.7 (NRST), XH6.3
GND: C1.2, C2.2, C3.2, C4.2, C5.2, C6.2, C7.2, C8.2, C9.2, C11.2, C12.2, C13.2, C14.2, L1.C, L2.C, L3.C, L4.C, L5.C, L6.C, L7.C, L8.C, L9.C, L10.C, L11.C, L12.C, P1.1, P1.2, P1.3, P1.4, P1.5, P1.6, R1.1, U1.GND, U1.GND1, U2.GND, U2.GND1, U3.GND, U3.GND1, U4.GND, U4.GND1, U6.12 (VSSA/VREF-), U6.18 (VSS), U6.31 (VSS), U6.47 (VSS), U6.63 (VSS), XH2.P$3 (3), XH3.P$2 (2), XH4.5, XH4.6, XH5.P$2 (2)
IR_RX: P2.2, XH1.3
IR_TX: P2.1, XH1.4
LED1: R2.2, U6.29 (PB10/TIM2_CH3/I2C2_SCL/SPI2_SCK/I2S2_CK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)
LED2: R3.2, U6.28 (PB2-BOOT1(PB2)/TIM2_CH4/SAI1_SD_A/SPI3_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)
LED3: R9.2, U6.27 (PB1/TIM1_CH3N/TIM3_CH4/TIM8_CH3N/OTG_HS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)
LED4: R10.2, U6.26 (PB0/TIM1_CH2N/TIM3_CH3/TIM8_CH2N/SPI3_M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)
LIDAR_RST: XH6.6
unnamed: C1.1, U6.30 (VCAP_1)
unnamed: R1.2, U6.60 (BOOT0)
unnamed: C2.1, U6.5 (PH0-OSC_IN/EVENTOUT), X2.P$2 (2)
unnamed: C3.1, U6.6 (PH1-OSC_OUT/EVENTOUT), X2.P$1 (1)
unnamed: L2.A, R3.1
unnamed: L4.A, R10.1
unnamed: L1.A, R2.1
unnamed: L6.A, R5.1
unnamed: L3.A, R9.1
unnamed: L5.A, R4.1
unnamed: L8.A, R7.1
unnamed: L7.A, R6.1
unnamed: L10.A, R11.1
unnamed: L9.A, R8.1
unnamed: L12.A, R13.1
unnamed: L11.A, R12.1
PA_13: U6.46 (PA13/JTMS-SWDIO/EVENTOUT), XH6.2
PA_14: U6.49 (PA14/JTCK-SWCLK/EVENTOUT), XH6.1
RXD0: P2.4, XH6.4
TXD0: P2.3, XH6.5
UI_RX_HV: Q2.3 (D), R15.1, XH4.1
UI_RX_LV: Q2.2 (S), R14.1, XH1.5
UI_TX_HV: Q3.3 (D), R17.1, XH4.2
UI_TX_LV: Q3.2 (S), R16.1, XH1.6

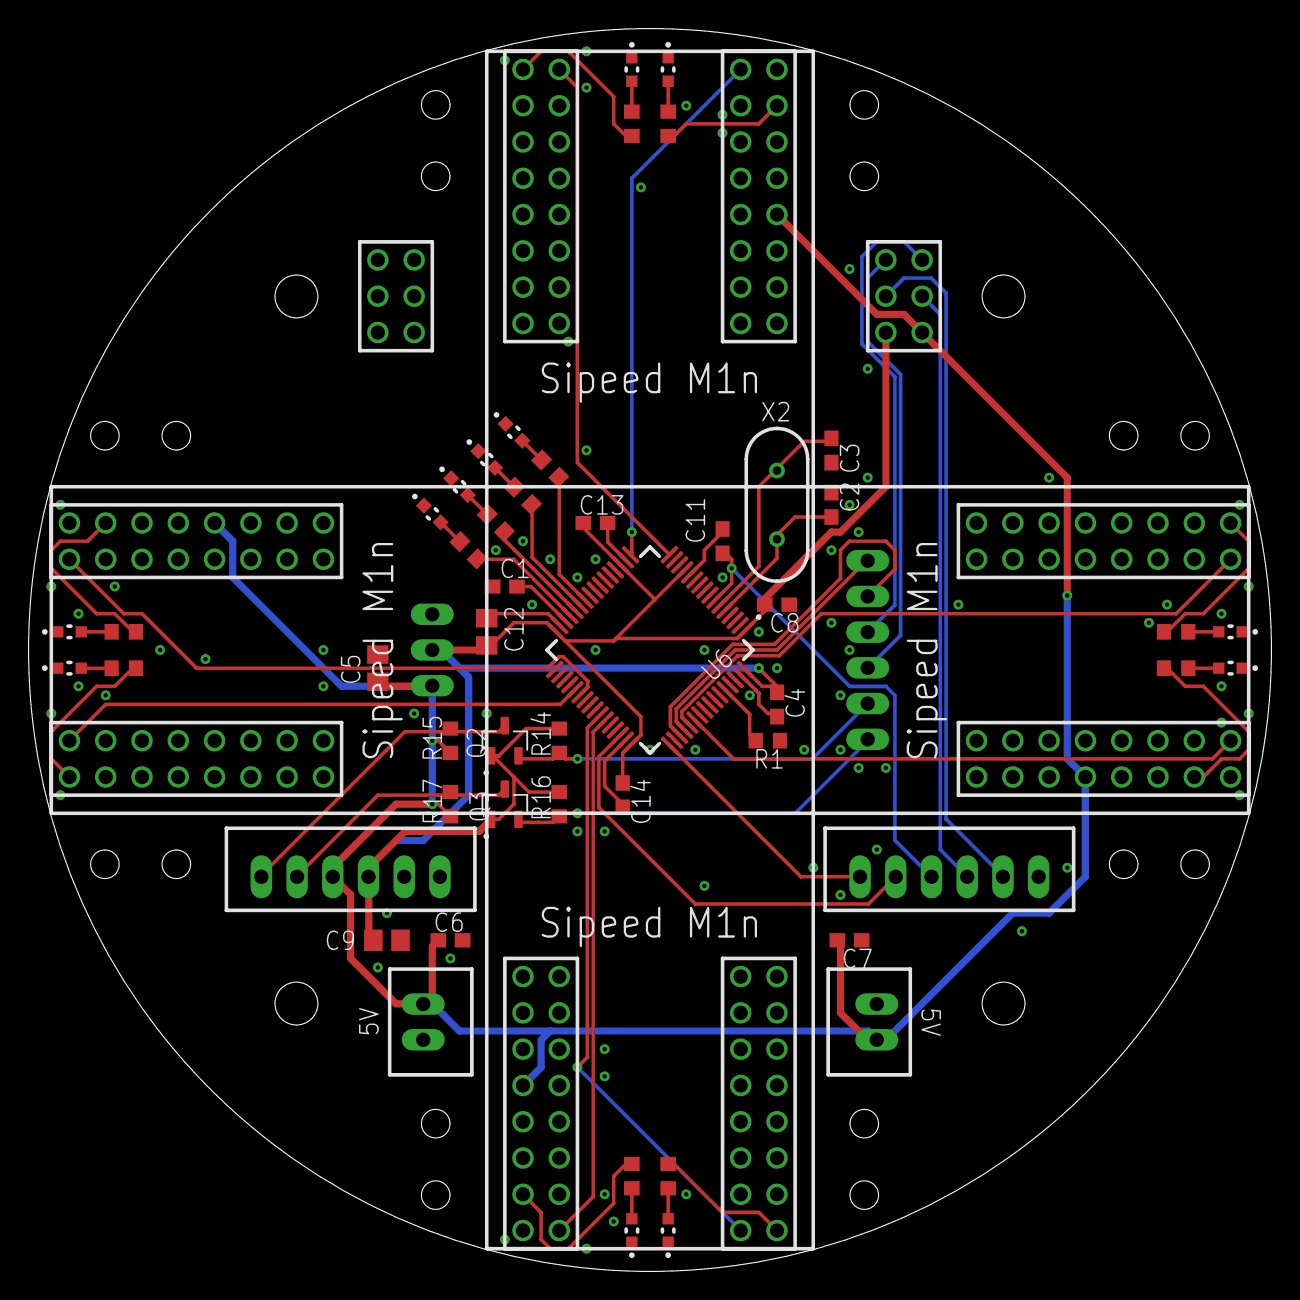
[picture p35: board cam_new.brd from above]

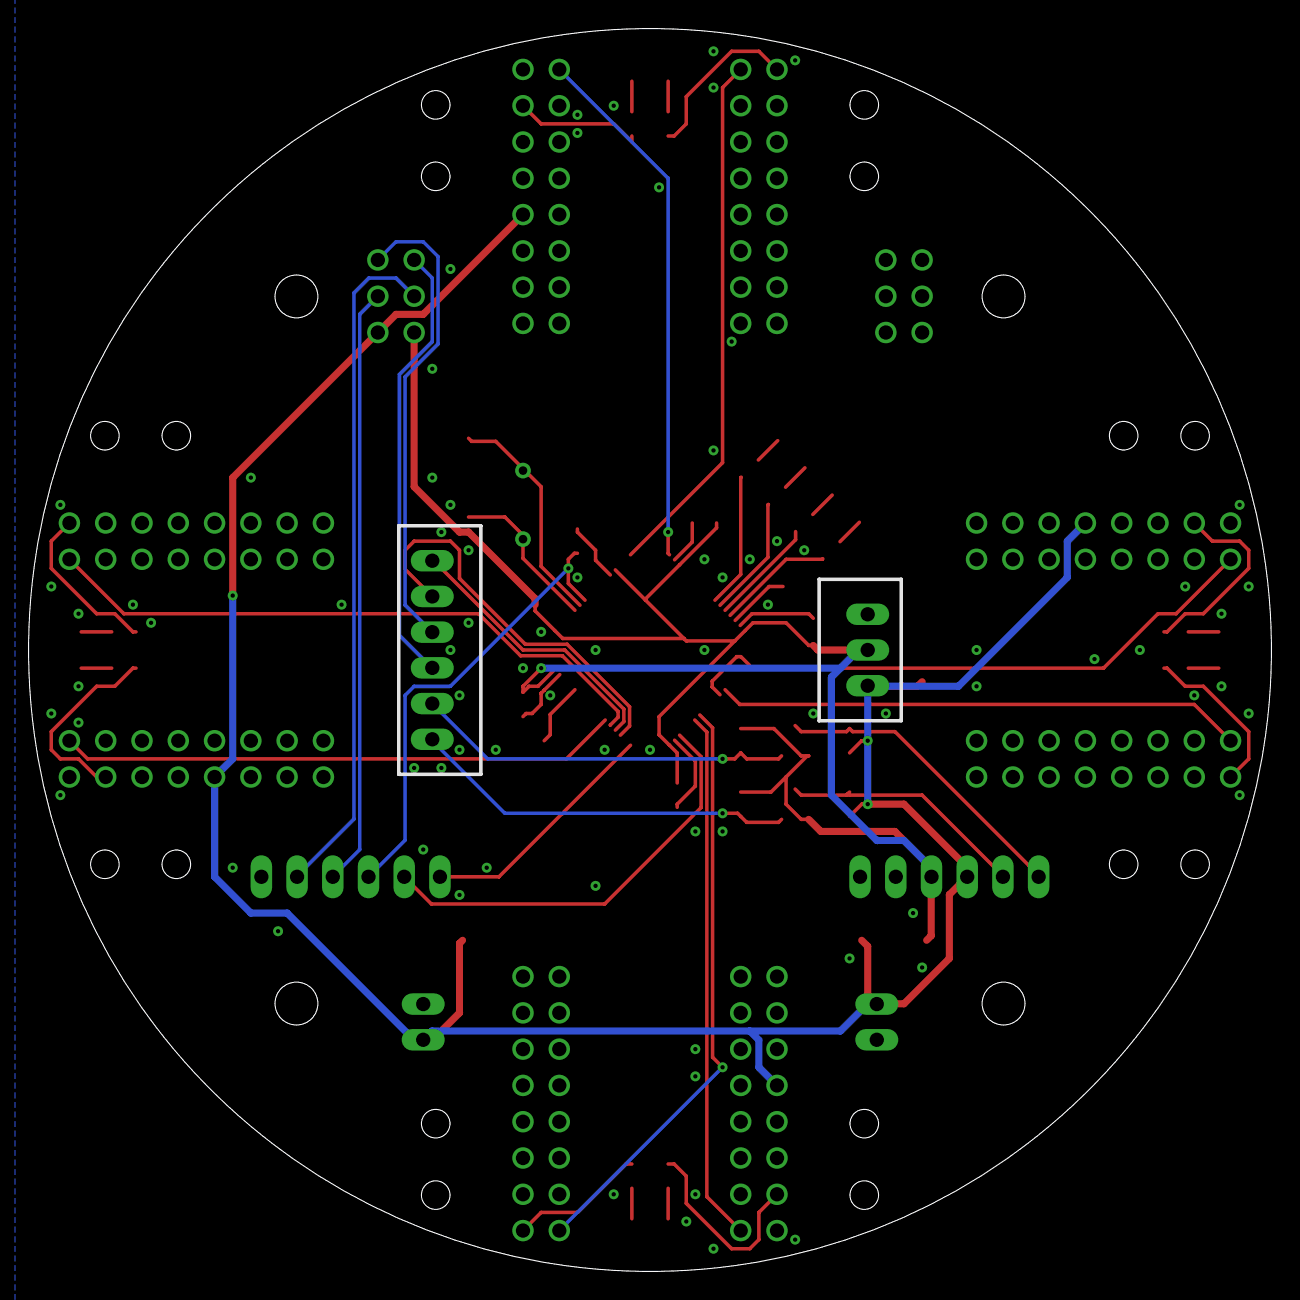
[picture p36: board cam_new.brd from below]

Board: 2 copper layers, 87.0 x 87.0 mm, 58 parts (2 on the bottom side), 52 nets.
