banbatakumi/RCJ2024_OPEN/Hardware/Curcuit/new_ball_catch/ball_catch_unit_back/ball_catch_unit_back.brd

## EAGLE design Hardware/Curcuit/new_ball_catch/ball_catch_unit_back/ball_catch_unit_back.brd (2025-04-20)

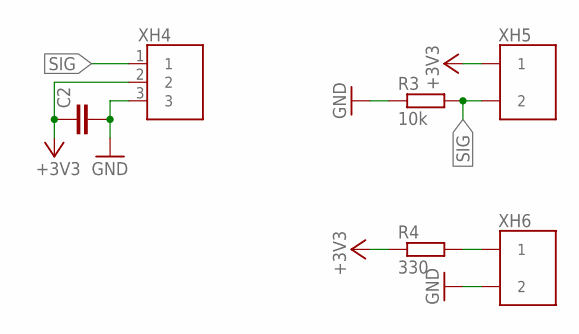
[picture p37: schematic ball_catch_unit_back.sch]

Parts:
C2: C-EUC0603; C0603
R3: 10k; 0204/7
R4: 330; 0204/7
XH4: S3B
XH5: 2B
XH6: S2B

Connections:
+3V3: C2.1, R4.1, XH4.2, XH5.1
GND: C2.2, R3.1, XH4.3, XH6.2
unnamed: R4.2, XH6.1
SIG: R3.2, XH4.1, XH5.2

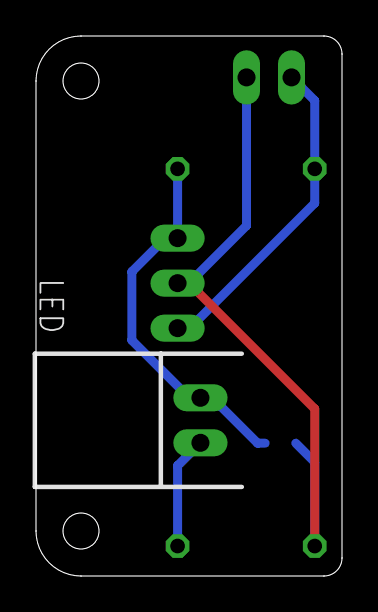
[picture p38: board ball_catch_unit_back.brd from above]

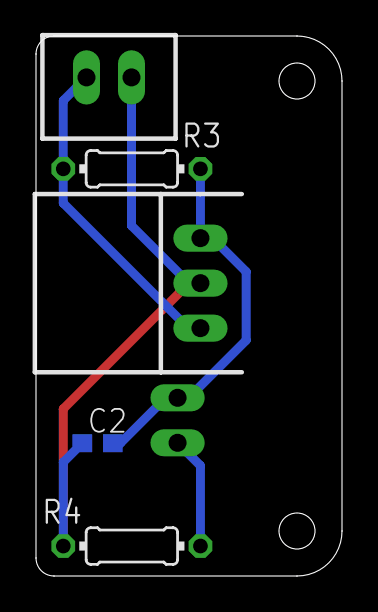
[picture p39: board ball_catch_unit_back.brd from below]

Board: 2 copper layers, 17.0 x 30.0 mm, 6 parts (5 on the bottom side), 4 nets.
