banbatakumi/RCJ2024_OPEN/Hardware/Curcuit/new_ball_catch/catch_sensor/catch_sensor.brd

## EAGLE design Hardware/Curcuit/new_ball_catch/catch_sensor/catch_sensor.brd (2025-04-20)

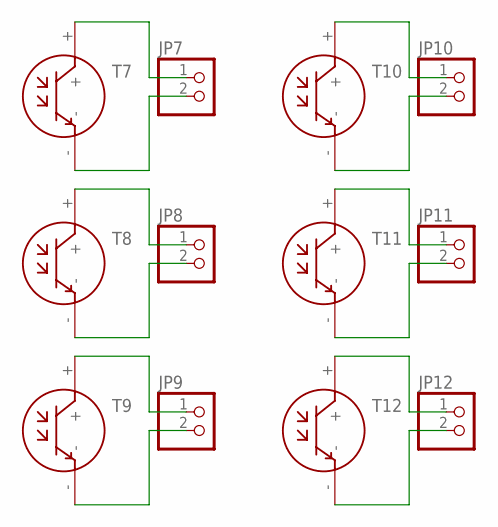
[picture p40: schematic catch_sensor.sch]

Parts:
JP7, JP8, JP9, JP10, JP11, JP12: PINHD-1X2; 1X02
T7, T8, T9, T10, T11, T12: NJL7302L-F3

Connections:
unnamed: JP7.1, T7.+
unnamed: JP7.2, T7.-
unnamed: JP8.1, T8.+
unnamed: JP8.2, T8.-
unnamed: JP9.1, T9.+
unnamed: JP9.2, T9.-
unnamed: JP10.1, T10.+
unnamed: JP10.2, T10.-
unnamed: JP11.1, T11.+
unnamed: JP11.2, T11.-
unnamed: JP12.1, T12.+
unnamed: JP12.2, T12.-

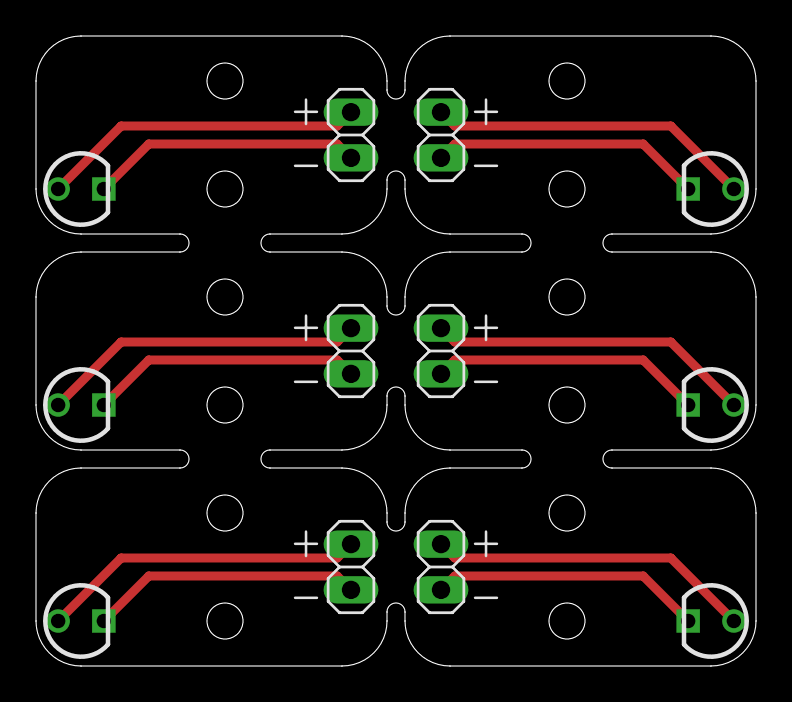
[picture p41: board catch_sensor.brd from above]

Board: 2 copper layers, 40.0 x 35.0 mm, 12 parts (0 on the bottom side), 12 nets.
