banbatakumi/RCJ2024_OPEN/Hardware/Curcuit/dribbler/dribbler.brd

## EAGLE design Hardware/Curcuit/dribbler/dribbler.brd (2025-04-20)

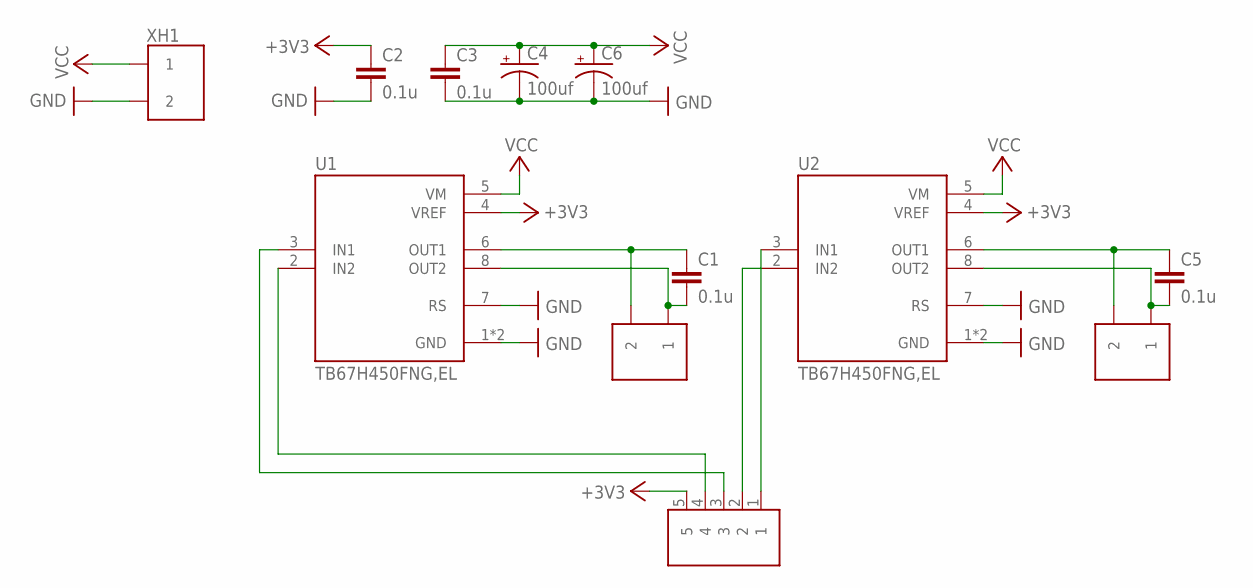
[picture p42: schematic dribbler.sch]

Parts:
C1, C2, C3, C5: 0.1u; C0603
C4, C6: 100uf; MH5
U1, U2: TB67H450FNG,EL; SOIC127P599X175-9N
U$1, U$3: S2B
U$2: S5B
XH1: S2B

Connections:
+3V3: C2.1, U1.4 (VREF), U2.4 (VREF), U$2.5
GND: C2.2, C3.2, C4.-, C6.-, U1.1 (GND), U1.7 (RS), U1.9 (GND), U2.1 (GND), U2.7 (RS), U2.9 (GND), XH1.2
unnamed: C5.1, U2.6 (OUT1), U$3.2
unnamed: C1.2, U1.8 (OUT2), U$1.1
unnamed: U1.3 (IN1), U$2.3
unnamed: U1.2 (IN2), U$2.4
unnamed: C5.2, U2.8 (OUT2), U$3.1
unnamed: U2.2 (IN2), U$2.2
unnamed: U2.3 (IN1), U$2.1
unnamed: C1.1, U1.6 (OUT1), U$1.2
VCC: C3.1, C4.+, C6.+, U1.5 (VM), U2.5 (VM), XH1.1

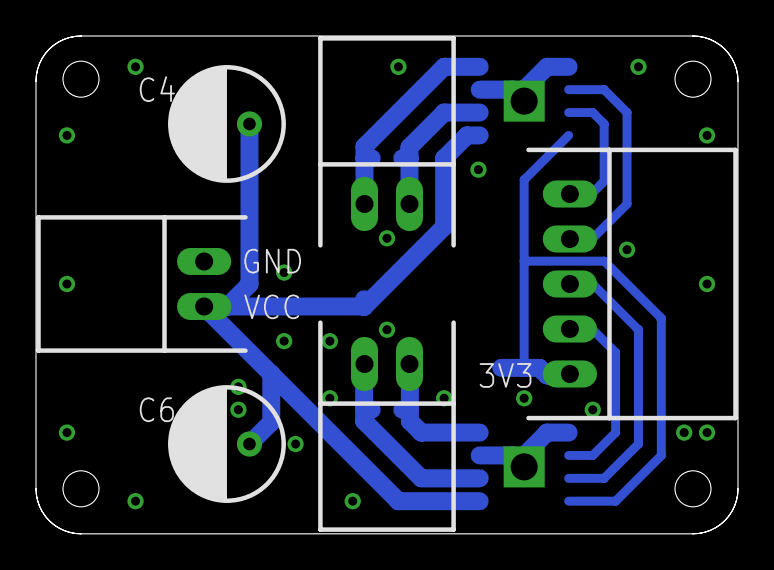
[picture p43: board dribbler.brd from above]

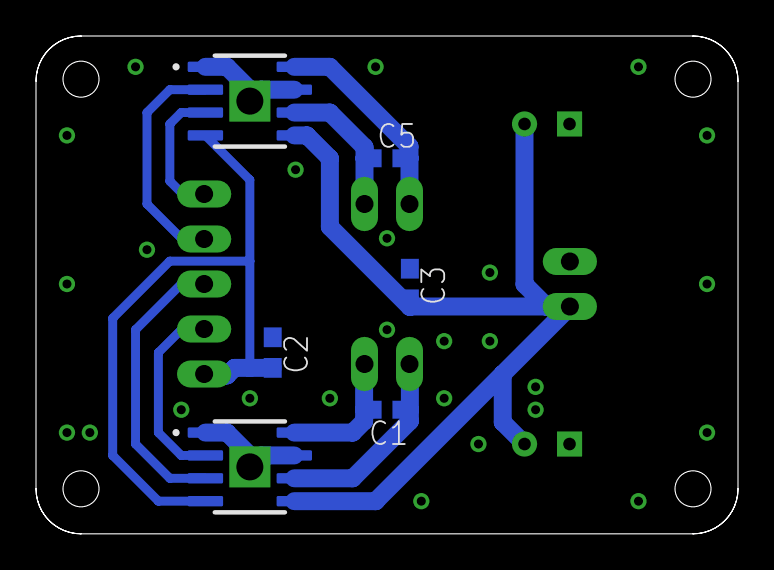
[picture p44: board dribbler.brd from below]

Board: 2 copper layers, 39.0 x 27.7 mm, 12 parts (6 on the bottom side), 11 nets.
