banbatakumi/RCJ2024_OPEN/Software/F446RE_main/F446RE_main.ioc

Mcu.UserName=STM32F446RETx
PA0-WKUP.Signal=UART4_TX
PA1.Signal=UART4_RX
PA10.Signal=USART1_RX
PA2.Signal=USART2_TX
PA3.Signal=USART2_RX
PA4.GPIO_Label=VOLTAGE
PA4.Signal=ADCx_IN4
PA5.GPIO_Label=LED1
PA5.Signal=GPIO_Output
PA6.GPIO_Label=LED_H
PA6.Signal=S_TIM13_CH1
PA9.Signal=USART1_TX
PB10.GPIO_Label=MOTOR2A
PB10.Signal=S_TIM2_CH3
PB14.GPIO_Label=MOTOR1B
PB14.Signal=S_TIM12_CH1
PB15.GPIO_Label=MOTOR1A
PB15.Signal=S_TIM12_CH2
PB2.GPIO_Label=MOTOR2B
PB2.Signal=S_TIM2_CH4
PB3.GPIO_Label=MOTOR3B
PB3.Signal=S_TIM2_CH2
PB5.GPIO_Label=MOTOR3A
PB5.Signal=S_TIM3_CH2
PB6.GPIO_Label=FRONT_DRIBBLER_A
PB6.Signal=S_TIM4_CH1
PB7.GPIO_Label=FRONT_DRIBBLER_B
PB7.Signal=S_TIM4_CH2
PB8.GPIO_Label=BACK_DRIBBLER_A
PB8.Signal=S_TIM2_CH1_ETR
PB9.GPIO_Label=BACK_DRIBBLER_B
PB9.Signal=S_TIM4_CH4
PC0.GPIO_Label=KICKER_CHARGE
PC0.Signal=GPIO_Output
PC1.GPIO_Label=KICKER_KICK
PC1.Signal=GPIO_Output
PC10.Signal=USART3_TX
PC11.Signal=USART3_RX
PC12.Signal=UART5_TX
PC4.GPIO_Label=HOLD_FRONT
PC4.Signal=ADCx_IN14
PC5.GPIO_Label=HOLD_BACK
PC5.Signal=ADCx_IN15
PC6.GPIO_Label=MOTOR4A
PC6.Signal=S_TIM3_CH1
PC8.GPIO_Label=MOTOR4B
PC8.Signal=S_TIM3_CH3
PD2.Signal=UART5_RX
