banbatakumi/RCJ2024_OPEN/Software/m1n_camera/main.py

import sensor, image
import Maix

from fpioa_manager import fm
from machine import UART
from Maix import GPIO
from micropython import const

#LED
fm.register(9, fm.fpioa.GPIO0)
fm.register(17, fm.fpioa.GPIO1)
led_g=GPIO(GPIO.GPIO0, GPIO.OUT)
led_r=GPIO(GPIO.GPIO1, GPIO.OUT)
led_g.value(1)

print("Current CPU Frequency: ", Maix.freq.get_cpu())
print("Current KPU Frequency: ", Maix.freq.get_kpu())

MODE=0

#定数定義
UART_SPEED = const(230400)
ANGLE_CONVERSION = 0.28125
WIDTH = const(320)
HEIGHT = const(184)
PROXIMITY_HEIGHT = const(110)
PROXIMITY_CNT_NUM = const(10)

#ホモグラフィー変換行列
homegraphy_matrix = [[ 0.062500,  -0.00000,  -0.00000 ],
                     [ 0.00000,   0.091912,   0.00000 ],
                     [ 0.00000,  -0.0055147,  1.0000  ]]


#センサーの設定
sensor.reset(freq = 24000000, set_regs = True, dual_buff = True)
sensor.set_pixformat(sensor.RGB565)
sensor.set_framesize(sensor.QVGA)
sensor.set_vflip(1)
sensor.set_hmirror(1)
sensor.set_windowing((WIDTH, HEIGHT))

sensor.set_auto_gain(False, gain_db = 0)
sensor.set_auto_whitebal(False, rgb_gain_db = (25, 20, 40))
sensor.set_auto_exposure(False)
sensor.set_contrast(2)
sensor.set_saturation(1)
sensor.skip_frames(time = 2000)
sensor.run(1)

camera_gain = sensor.get_gain_db()
sensor.set_auto_gain(False, gain_db = camera_gain)

#UART設定
fm.register(10, fm.fpioa.UART1_TX, force = True)
fm.register(11, fm.fpioa.UART1_RX, force = True)

uart = UART(UART.UART1, UART_SPEED, 8, None, 1, timeout = 1000, read_buf_len = 4096)

#各閾値
ball_thresholds = [(20, 73, 37, 65, 46, 81)]
y_goal_thresholds = [(9, 97, -13, 19, 36, 72)]
b_goal_thresholds = [(9, 97, -6, 12, -44, -28)]

court_thresholds = [(0, 100, -35, -6, -14, 10)]

ball_roi_cut_top = 14
court_roi_cut_top = 14
goal_roi_cut_bottom = 84
ball_roi = [0, ball_roi_cut_top, WIDTH, HEIGHT - ball_roi_cut_top]
court_roi = [0, court_roi_cut_top, WIDTH, HEIGHT - ball_roi_cut_top]
goal_roi = [0, 0, WIDTH, HEIGHT - goal_roi_cut_bottom]

#変数定義
proximity_cnt = [0] * 7
proximity = [0] * 7

led_g.value(0)

def MatrixMultiply(matrix, vector): #行列の積を計算する関数
    result = [[sum(a * b for a, b in zip(row, col)) for col in zip(*vector)] for row in matrix]
    return result

def CheckGreen(x, y):
    def Check(thresholds, lab):
        l_min, l_max, a_min, a_max, b_min, b_max = thresholds[0]
        return 1 if l_min < lab[0] < l_max and a_min < lab[1] < a_max and b_min < lab[2] < b_max else 0

    bit = []
    for dx in [-3, 0, 3]:
        for dy in [-3, 0, 3]:
            bit.append(Check(court_thresholds, image.rgb_to_lab(img.get_pixel(x + dx, y + dy))))

    return 0 if any(bit) else 1

def HomographyProjection(center_x, center_y): #ホモグラフィー変換をする関数
    #カメラ座標でのコートベクトル
    camera_vector = [[center_x],
                     [center_y],
                     [1       ]]

    #ワールド座標に変換
    coordinate = MatrixMultiply(homegraphy_matrix, camera_vector)
    world_vector = [[coordinate[0][0] / coordinate[2][0]],
                    [coordinate[1][0] / coordinate[2][0]]]
    return world_vector

def MySqrt(x):
    if x < 0:
        return 0

    s = x if x > 1 else 1

    while True:
        last = s
        s = (x / s + s) * 0.5
        if s >= last:
            break

    return last


while True:
    img = sensor.snapshot() #映像の取得

    #ボールを見つける
    ball_rectarray = []
    ball_x = 0
    ball_y = 0
    for blob in img.find_blobs(ball_thresholds, roi = ball_roi, pixel_threshold = 1, area_threshold = 1, merge = True, margin = 10):
        if blob[2] < 150:
            ball_rectarray.append(list(blob.rect()))     #見つかった閾値内のオブジェクトをリストに格納

    try:
        ball_maxrect = max(ball_rectarray, key = lambda x: x[1])    #配列の中から一番画面の下にあるものを選定
        ball_x = ball_maxrect[0] + (ball_maxrect[2] * 0.5)  #中心のx座標の算出
        ball_y = ball_maxrect[1] + (ball_maxrect[3] * 0.5)  #中心のy座標の算出
        if MODE == 1:
            img.draw_circle(int(ball_x), int(ball_y), int((ball_maxrect[2] * 0.5 + ball_maxrect[3] * 0.5) * 0.5))

    except ValueError as err:   #オブジェクトがひとつも見つからなかった場合の例外処理
        pass

    #黄色ゴールを見つける
    y_goal_rectarray = []
    y_goal_x = 0
    y_goal_y = 0
    y_goal_width = 0

    for blob in img.find_blobs(y_goal_thresholds, roi = goal_roi, pixel_threshold = 100, area_threshold = 100, merge = True, margin = 75):
        y_goal_rectarray.append(list(blob.rect()))     #見つかった閾値内のオブジェクトをリストに格納

    try:
        y_goal_maxrect = max(y_goal_rectarray, key = lambda x: x[2] * x[3])    #配列の中から面積の一番大きい物を選定
        y_goal_x = y_goal_maxrect[0] + (y_goal_maxrect[2] * 0.5)  #中心のx座標の算出
        y_goal_y = y_goal_maxrect[1] + y_goal_maxrect[3]
        y_goal_width = y_goal_maxrect[2]
        if MODE == 1:
            img.draw_rectangle(y_goal_maxrect)     #オブジェクトを囲う四角形の描画
            img.draw_string(y_goal_maxrect[0], y_goal_maxrect[1] - 12, "yellow goal")

    except ValueError as err:   #オブジェクトがひとつも見つからなかった場合の例外処理
        pass

    #青色ゴールを見つける
    b_goal_rectarray = []
    b_goal_x = 0
    b_goal_y = 0
    b_goal_width = 0

    for blob in img.find_blobs(b_goal_thresholds, roi = goal_roi, pixel_threshold = 100, area_threshold = 100, merge = True, margin = 75):
        b_goal_rectarray.append(list(blob.rect()))     #見つかった閾値内のオブジェクトをリストに格納

    try:
        b_goal_maxrect = min(b_goal_rectarray, key = lambda x: x[2] * x[3])    #配列の中から面積の一番大きい物を選定
        b_goal_x = b_goal_maxrect[0] + (b_goal_maxrect[2] * 0.5)  #中心のx座標の算出
        b_goal_y = b_goal_maxrect[1] + b_goal_maxrect[3]
        b_goal_width = b_goal_maxrect[2]
        if MODE == 1:
            img.draw_rectangle(b_goal_maxrect)     #オブジェクトを囲う四角形の描画
            img.draw_string(b_goal_maxrect[0], b_goal_maxrect[1] - 12, "blue goal")

    except ValueError as err:   #オブジェクトがひとつも見つからなかった場合の例外処理
        pass

    court_rectarray = []
    court_y = 0

    for blob in img.find_blobs(court_thresholds, roi = court_roi, pixel_threshold = 1000, area_threshold = 1000, merge = True, margin = 1000):
        court_rectarray.append(list(blob.rect()))     #見つかった閾値内のオブジェクトをリストに格納

    try:
        court_maxrect = max(court_rectarray, key = lambda x: x[2] * x[3])  # Y座標が一番大きい要素を選定
        court_y = court_maxrect[1]
        if MODE == 1:
            img.draw_line(0, court_maxrect[1], 320, court_maxrect[1])
            img.draw_string(court_maxrect[0], court_maxrect[1] - 12, "court")

    except ValueError as err:   #オブジェクトがひとつも見つからなかった場合の例外処理
        pass

    world_court_vector = HomographyProjection(0, 184 - court_y)
    court_dis = int(world_court_vector[1][0] * 2)
    if court_dis > 200:
        court_dis = 200
    if court_y == 0:
        court_dis = 0

    #取得した値を変換
    ball_dir = int(ball_x * ANGLE_CONVERSION) #ボールの角度を求める

    #カメラ座標でのボールベクトル
    world_ball_vector = HomographyProjection(ball_x - 160, 184 - ball_y)

    #ボールベクトルの大きさ
    ball_dis = int(MySqrt((world_ball_vector[0][0] - (ball_x - 160) * 0.0625) ** 2 + world_ball_vector[1][0] ** 2) * 2)

    #範囲保証
    if(ball_dis > 200):
        ball_dis = 200
    if ball_x == 0 or ball_y == 0:
        ball_dis = 0

    y_goal_dir = int(y_goal_x * ANGLE_CONVERSION)
    y_goal_vector = HomographyProjection(y_goal_x - 160, 184 - y_goal_y)
    y_goal_dis = int(MySqrt(y_goal_vector[0][0] ** 2 + y_goal_vector[1][0] ** 2) * 2)
    if y_goal_dis > 200:
        y_goal_dis = 200
    if y_goal_y == 0:
        y_goal_dis = 0

    b_goal_dir = int(b_goal_x * ANGLE_CONVERSION)
    b_goal_vector = HomographyProjection(b_goal_x - 160, 184 - b_goal_y)
    b_goal_dis = int(MySqrt(b_goal_vector[0][0] ** 2 + b_goal_vector[1][0] ** 2) * 2)
    if b_goal_dis > 200:
        b_goal_dis = 200
    if b_goal_y == 0:
        b_goal_dis = 0

    is_goal_front = 0
    own_dir = 0

    if(uart.any()):#UART受信
        own_dir = uart.readchar() * 2 - 180
    robot_center = 160 + own_dir * ANGLE_CONVERSION

    if(y_goal_dis > b_goal_dis): #黄ゴールが見つかった時
        is_y_goal = 1
        goal_dir = y_goal_dir
        goal_dis = y_goal_dis
        if(y_goal_x + (y_goal_width * 0.5) < robot_center + 10 or y_goal_x - (y_goal_width * 0.5) > robot_center - 10):
            is_goal_front = 0
        else:
            is_goal_front = 1
    else: #青ゴールが見つかった時
        is_y_goal = 0
        goal_dir = b_goal_dir
        goal_dis = b_goal_dis
        if(b_goal_x + (b_goal_width * 0.5) < robot_center + 10 or b_goal_x - (b_goal_width * 0.5) > robot_center - 10):
            is_goal_front = 0
        else:
            is_goal_front = 1

    bool_data = (is_goal_front << 1) | is_y_goal

    #擬似LiDAR
    proximity[0] = CheckGreen(40, PROXIMITY_HEIGHT)
    proximity[1] = CheckGreen(80, PROXIMITY_HEIGHT)
    proximity[2] = CheckGreen(120, PROXIMITY_HEIGHT)
    proximity[3] = CheckGreen(160, PROXIMITY_HEIGHT)
    proximity[4] = CheckGreen(200, PROXIMITY_HEIGHT)
    proximity[5] = CheckGreen(240, PROXIMITY_HEIGHT)
    proximity[6] = CheckGreen(280, PROXIMITY_HEIGHT)
    if MODE == 1:
        img.draw_cross(40, PROXIMITY_HEIGHT)
        img.draw_cross(80, PROXIMITY_HEIGHT)
        img.draw_cross(120, PROXIMITY_HEIGHT)
        img.draw_cross(160, PROXIMITY_HEIGHT)
        img.draw_cross(200, PROXIMITY_HEIGHT)
        img.draw_cross(240, PROXIMITY_HEIGHT)
        img.draw_cross(280, PROXIMITY_HEIGHT)
    for i in range(0, 7):
        if proximity[i] == 1:
            if proximity[i] < PROXIMITY_CNT_NUM:
                proximity_cnt[i] += 1
        else:
            proximity_cnt[i] = 0
        if proximity_cnt[i] >= PROXIMITY_CNT_NUM:
            proximity[i] = 1
        else:
            proximity[i] = 0

    proximity_data = proximity[0] << 6 | proximity[1] << 5 | proximity[2] << 4 | proximity[3] << 3 | proximity[4] << 2 | proximity[5] << 1 | proximity[6]

    #uart送信
    send_data = bytearray([0xFF, ball_dir, ball_dis, goal_dir, goal_dis, court_dis, bool_data, proximity_data, 0xAA])
    uart.write(send_data)
