banbatakumi/RCJ2024_OPEN/Software/F446RE_main/Core/Inc/main.h

#define KICKER_CHARGE_Pin GPIO_PIN_0
#define KICKER_CHARGE_GPIO_Port GPIOC
#define KICKER_KICK_Pin GPIO_PIN_1
#define KICKER_KICK_GPIO_Port GPIOC
#define VOLTAGE_Pin GPIO_PIN_4
#define VOLTAGE_GPIO_Port GPIOA
#define LED1_Pin GPIO_PIN_5
#define LED1_GPIO_Port GPIOA
#define LED_H_Pin GPIO_PIN_6
#define LED_H_GPIO_Port GPIOA
#define HOLD_FRONT_Pin GPIO_PIN_4
#define HOLD_FRONT_GPIO_Port GPIOC
#define HOLD_BACK_Pin GPIO_PIN_5
#define HOLD_BACK_GPIO_Port GPIOC
#define MOTOR2B_Pin GPIO_PIN_2
#define MOTOR2B_GPIO_Port GPIOB
#define MOTOR2A_Pin GPIO_PIN_10
#define MOTOR2A_GPIO_Port GPIOB
#define MOTOR1B_Pin GPIO_PIN_14
#define MOTOR1B_GPIO_Port GPIOB
#define MOTOR1A_Pin GPIO_PIN_15
#define MOTOR1A_GPIO_Port GPIOB
#define MOTOR4A_Pin GPIO_PIN_6
#define MOTOR4A_GPIO_Port GPIOC
#define MOTOR4B_Pin GPIO_PIN_8
#define MOTOR4B_GPIO_Port GPIOC
#define MOTOR3B_Pin GPIO_PIN_3
#define MOTOR3B_GPIO_Port GPIOB
#define MOTOR3A_Pin GPIO_PIN_5
#define MOTOR3A_GPIO_Port GPIOB
#define FRONT_DRIBBLER_A_Pin GPIO_PIN_6
#define FRONT_DRIBBLER_A_GPIO_Port GPIOB
#define FRONT_DRIBBLER_B_Pin GPIO_PIN_7
#define FRONT_DRIBBLER_B_GPIO_Port GPIOB
#define BACK_DRIBBLER_A_Pin GPIO_PIN_8
#define BACK_DRIBBLER_A_GPIO_Port GPIOB
#define BACK_DRIBBLER_B_Pin GPIO_PIN_9
#define BACK_DRIBBLER_B_GPIO_Port GPIOB
