banbatakumi/RCJ2024_OPEN/Software/F446RE_line/src/app/config.h

#ifndef __Parametors__
#define __Parametors__

#define MAIN_FREQ 5000  // Hz
#define PERIOD_US (int)((1.0f / MAIN_FREQ) * 1000000)

#define SEND_FREQ 2500  // Hz
#define SEND_PERIOD_US (int)((1.0f / SEND_FREQ) * 1000000)

#endif
