banbatakumi/RCJ2024_OPEN/(commit log)

2025-04-20 add curcuit files
    [Line.brd, Line.sch, MD.brd, MD.sch, ball_catch_order.brd, ball_catch_order.sch, ball_catch_unit_back.brd, ball_catch_unit_back.sch]
2025-04-20 閾値と待機時間変更
2025-04-20 cortex-debugの変数代入をコメントアウト
2025-04-20 デバッグモードの追加
2025-04-20 ちょっとだけ高速化
2025-04-20 ホモグラフィー行列生成プログラムの追加
2025-04-20 オーバークロックプログラム
2025-04-20 起動時安定化
