banbatakumi/RCJ2024_OPEN/(notices)

Notices in the files:
Software/F446RE_main/Core/Inc/main.h:
Copyright (c) 2025 STMicroelectronics.
All rights reserved.
This software is licensed under terms that can be found in the LICENSE file
